LeadFreeCandy/Flux-Chess/esp32/docs/force_table_vectors.png

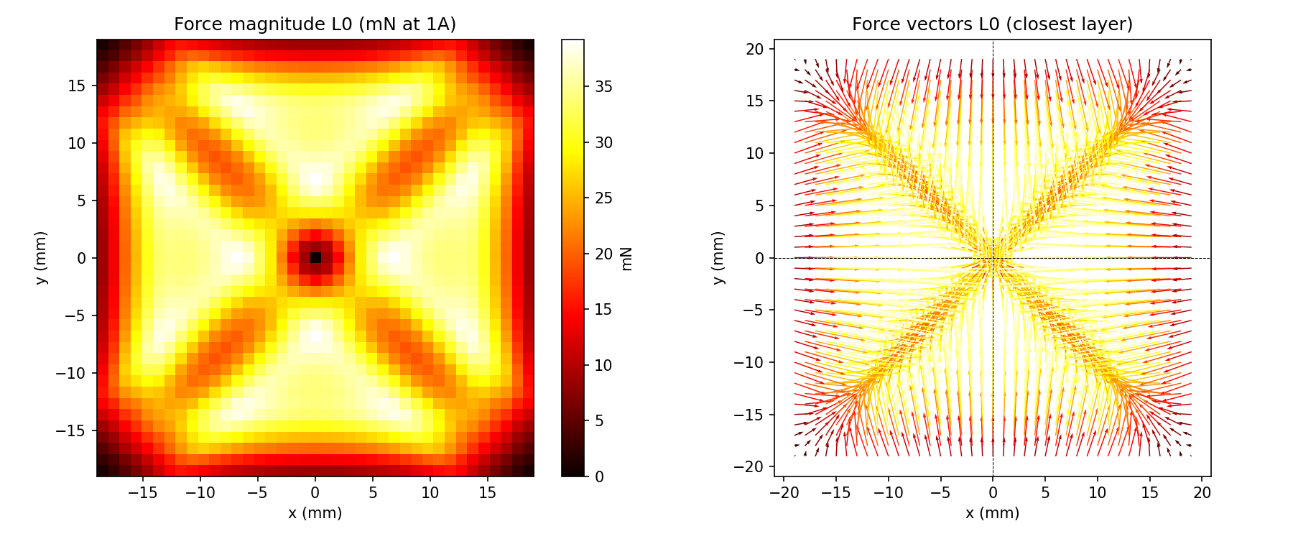
esp32/docs/force_table_vectors.png
