LeadFreeCandy/Flux-Chess/esp32/docs/force_table_layers.png

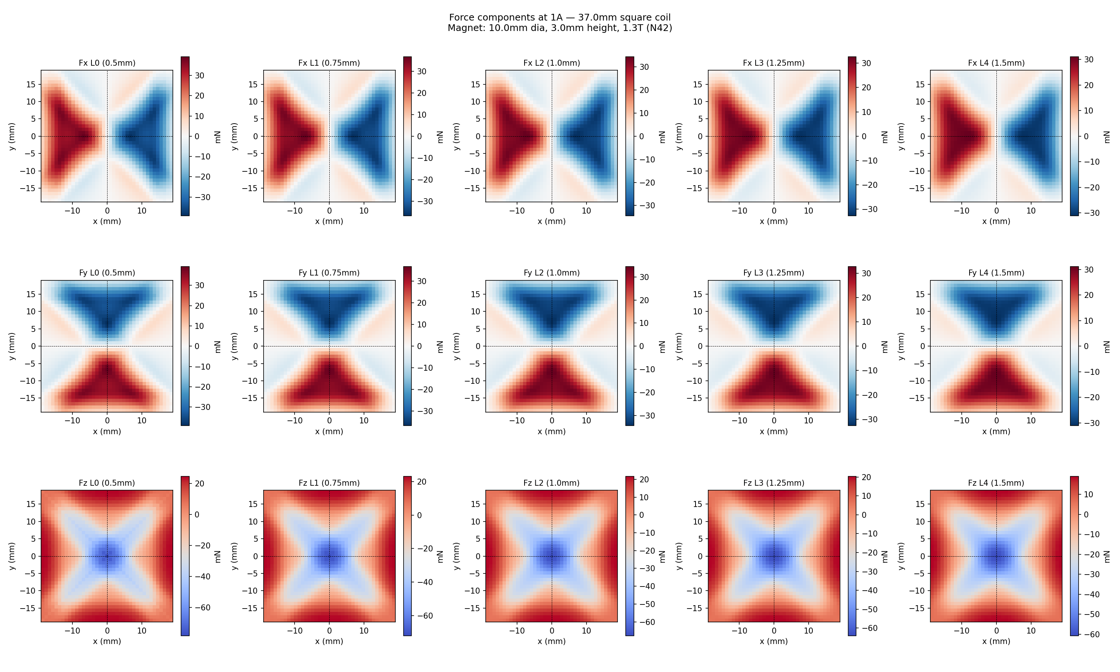
esp32/docs/force_table_layers.png
