LeadFreeCandy/Flux-Chess/coil_generation/coils_overlay.png

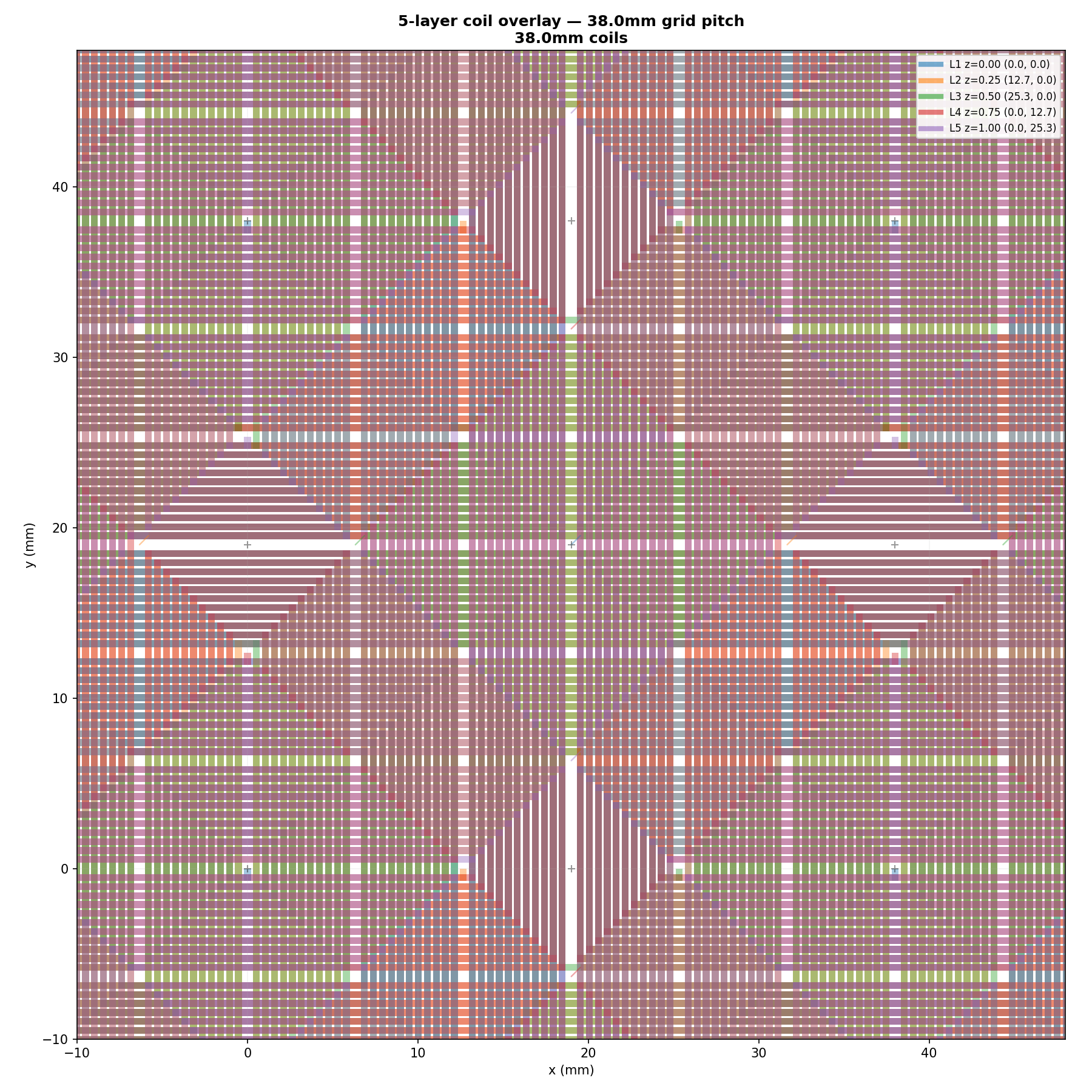
coil_generation/coils_overlay.png
