LeadFreeCandy/Flux-Chess/(list of files, cad)

Other CAD files:
pawn.dxf
