LeadFreeCandy/Flux-Chess/esp32/firmware/serial_server.h

#pragma once
#include <functional>
#include "board.h"

// ── Command Registry ──────────────────────────────────────────

using CommandHandler = std::function<String(Board& board, const String& params)>;

struct Command {
  const char* name;
  CommandHandler handler;
};

// ── Built-in command handlers ─────────────────────────────────

inline String handlePulseCoil(Board& board, const String& params) {
  return board.pulseCoil(
    jsonGet(params, "x").toInt(),
    jsonGet(params, "y").toInt(),
    jsonGet(params, "duration_ms").toInt()
  ).toJson();
}

inline String handleGetBoardState(Board& board, const String&) {
  return board.getBoardState().toJson();
}

inline String handleSetRGB(Board& board, const String& params) {
  return board.setRGB(
    jsonGet(params, "r").toInt(),
    jsonGet(params, "g").toInt(),
    jsonGet(params, "b").toInt()
  ).toJson();
}

inline String handleSetPiece(Board& board, const String& params) {
  uint8_t x = jsonGet(params, "x").toInt();
  uint8_t y = jsonGet(params, "y").toInt();
  uint8_t id = jsonGet(params, "id").toInt();
  board.setPiece(x, y, id);
  return Json().add("success", true).build();
}

inline String handleMoveDumb(Board& board, const String& params) {
  uint8_t fromX = jsonGet(params, "from_x").toInt();
  uint8_t fromY = jsonGet(params, "from_y").toInt();
  uint8_t toX = jsonGet(params, "to_x").toInt();
  uint8_t toY = jsonGet(params, "to_y").toInt();
  MoveError err = board.moveDumbOrthogonal(fromX, fromY, toX, toY);
  return Json()
    .add("success", err == MoveError::NONE)
    .add("error", err)
    .build();
}

inline String handleMovePhysics(Board& board, const String& params) {
  uint8_t fromX = jsonGet(params, "from_x").toInt();
  uint8_t fromY = jsonGet(params, "from_y").toInt();
  uint8_t toX = jsonGet(params, "to_x").toInt();
  uint8_t toY = jsonGet(params, "to_y").toInt();
  int maxRetries = jsonGet(params, "max_retries").toInt();  // defaults to 0 if absent
  MoveDiag diag;
  MoveError err = board.movePhysicsOrthogonal(fromX, fromY, toX, toY, false, maxRetries, &diag);
  MoveResponse res;
  res.success = (err == MoveError::NONE);
  res.error = err;
  res.has_diag = true;
  res.diag = diag;
  return res.toJson();
}

inline String handleMovePiece(Board& board, const String& params) {
  uint8_t fromX = jsonGet(params, "from_x").toInt();
  uint8_t fromY = jsonGet(params, "from_y").toInt();
  uint8_t toX = jsonGet(params, "to_x").toInt();
  uint8_t toY = jsonGet(params, "to_y").toInt();
  int maxRetries = jsonGet(params, "max_retries").toInt();
  MoveError err = board.movePiece(fromX, fromY, toX, toY, maxRetries);
  MoveResponse res;
  res.success = (err == MoveError::NONE);
  res.error = err;
  return res.toJson();
}

inline String handleSetPhysicsParams(Board& board, const String& params) {
  PhysicsParams p = board.getPhysicsParams();
  String v;
  if ((v = jsonGet(params, "piece_mass_g")).length())         p.piece_mass_g = v.toFloat();
  if ((v = jsonGet(params, "max_current_a")).length())        p.max_current_a = v.toFloat();
  if ((v = jsonGet(params, "mu_static")).length())            p.mu_static = v.toFloat();
  if ((v = jsonGet(params, "mu_kinetic")).length())           p.mu_kinetic = v.toFloat();
  if ((v = jsonGet(params, "target_velocity_mm_s")).length()) p.target_velocity_mm_s = v.toFloat();
  if ((v = jsonGet(params, "target_accel_mm_s2")).length())   p.target_accel_mm_s2 = v.toFloat();
  if ((v = jsonGet(params, "max_jerk_mm_s3")).length())       p.max_jerk_mm_s3 = v.toFloat();
  if ((v = jsonGet(params, "coast_friction_offset")).length()) p.coast_friction_offset = v.toFloat();
  if ((v = jsonGet(params, "brake_pulse_ms")).length())       p.brake_pulse_ms = v.toInt();
  if ((v = jsonGet(params, "pwm_freq_hz")).length())          p.pwm_freq_hz = v.toInt();
  if ((v = jsonGet(params, "pwm_compensation")).length())     p.pwm_compensation = v.toFloat();
  if ((v = jsonGet(params, "all_coils_equal")).length())      p.all_coils_equal = (v == "true" || v == "1");
  if ((v = jsonGet(params, "force_scale")).length())          p.force_scale = v.toFloat();
  if ((v = jsonGet(params, "max_duration_ms")).length())      p.max_duration_ms = v.toInt();
  if ((v = jsonGet(params, "max_retry_attempts")).length())  p.max_retry_attempts = v.toInt();
  if ((v = jsonGet(params, "tick_ms")).length())             p.tick_ms = v.toInt();
  if ((v = jsonGet(params, "droop_per_piece")).length())     p.droop_per_piece = v.toFloat();
  board.setPhysicsParams(p);
  return board.physicsParamsToJson();
}

inline String handleGetPhysicsParams(Board& board, const String&) {
  return board.physicsParamsToJson();
}

inline String handleDiagonalTest(Board& board, const String& params) {
  uint8_t fromX = jsonGet(params, "from_x").toInt();
  uint8_t fromY = jsonGet(params, "from_y").toInt();
  uint8_t toX = jsonGet(params, "to_x").toInt();
  uint8_t toY = jsonGet(params, "to_y").toInt();
  Board::DiagonalParams dp;
  String v;
  if ((v = jsonGet(params, "catapult_ms")).length())   dp.catapult_ms = v.toInt();
  if ((v = jsonGet(params, "catapult_duty")).length())  dp.catapult_duty = v.toInt();
  if ((v = jsonGet(params, "delay1_ms")).length())      dp.delay1_ms = v.toInt();
  if ((v = jsonGet(params, "catch_ms")).length())       dp.catch_ms = v.toInt();
  if ((v = jsonGet(params, "catch_duty")).length())     dp.catch_duty = v.toInt();
  if ((v = jsonGet(params, "delay2_ms")).length())      dp.delay2_ms = v.toInt();
  if ((v = jsonGet(params, "center_ms")).length())      dp.center_ms = v.toInt();
  return board.diagonalTest(fromX, fromY, toX, toY, dp);
}

inline String handleMoveMulti(Board& board, const String& params) {
  // Parse array of moves: "moves": [{"from_x":0,"from_y":0,"to_x":3,"to_y":0}, ...]
  // Simple parsing: look for from_x/from_y/to_x/to_y with index suffixes
  Board::MultiMoveRequest moves[Board::MAX_MULTI_MOVES];
  int count = 0;

  for (int i = 0; i < Board::MAX_MULTI_MOVES; i++) {
    String prefix = String(i) + "_";
    String fx = jsonGet(params, (prefix + "from_x").c_str());
    if (!fx.length()) break;
    moves[count].from_x = fx.toInt();
    moves[count].from_y = jsonGet(params, (prefix + "from_y").c_str()).toInt();
    moves[count].to_x = jsonGet(params, (prefix + "to_x").c_str()).toInt();
    moves[count].to_y = jsonGet(params, (prefix + "to_y").c_str()).toInt();
    count++;
  }

  if (count == 0) {
    return Json().add("success", false).addStr("error", "no moves").build();
  }

  return board.moveMulti(moves, count);
}

inline String handleEdgeMoveTest(Board& board, const String& params) {
  bool up = jsonGet(params, "direction") != "down";
  Board::EdgeMoveParams ep;
  String v;
  if ((v = jsonGet(params, "pulse_ms")).length()) ep.pulse_ms = v.toInt();
  if ((v = jsonGet(params, "duty")).length())     ep.duty = v.toInt();
  if ((v = jsonGet(params, "delay_ms")).length()) ep.delay_ms = v.toInt();
  if ((v = jsonGet(params, "steps")).length())    ep.steps = v.toInt();
  return board.edgeMoveTest(up, ep);
}

inline String handleCenterPiece(Board& board, const String& params) {
  Board::CenterPieceParams cp;
  String v;
  if ((v = jsonGet(params, "x")).length())          cp.x = v.toInt();
  if ((v = jsonGet(params, "y")).length())          cp.y = v.toInt();
  if ((v = jsonGet(params, "center1_ms")).length()) cp.center1_ms = v.toInt();
  if ((v = jsonGet(params, "adj_ms")).length())     cp.adj_ms = v.toInt();
  if ((v = jsonGet(params, "between_ms")).length()) cp.between_ms = v.toInt();
  if ((v = jsonGet(params, "axis_switch_ms")).length()) cp.axis_switch_ms = v.toInt();
  if ((v = jsonGet(params, "center2_ms")).length()) cp.center2_ms = v.toInt();
  if ((v = jsonGet(params, "adj_repeats")).length()) cp.adj_repeats = v.toInt();
  return board.centerPiece(cp);
}

inline String handleResetBoard(Board& board, const String&) {
  return board.resetBoard();
}

inline String handleHexapawnPlay(Board& board, const String& params) {
  uint16_t hint_ms = 0;
  uint16_t hint_interval_ms = 1000;
  String v = jsonGet(params, "hint_pulse_ms");
  if (v.length()) hint_ms = v.toInt();
  v = jsonGet(params, "hint_interval_ms");
  if (v.length()) hint_interval_ms = v.toInt();
  return board.hexapawnPlay(hint_ms, hint_interval_ms);
}

inline String handleTunePhysics(Board& board, const String& params) {
  return board.tunePhysics();
}

inline String handleGetCalibration(Board& board, const String&) {
  return board.getCalibration().toJson();
}

inline String handleCalibrate(Board& board, const String&) {
  return board.calibrate().toJson();
}

inline String handleShutdown(Board& board, const String&) {
  return ShutdownResponse{}.toJson();
}

// ── Serial Server ─────────────────────────────────────────────

class SerialServer {
public:
  SerialServer(Board& board) : board_(board), num_commands_(0) {
    on("pulse_coil", handlePulseCoil);
    on("get_board_state", handleGetBoardState);
    on("set_piece", handleSetPiece);
    on("move_dumb", handleMoveDumb);
    on("move_physics", handleMovePhysics);
    on("move_piece", handleMovePiece);
    on("set_physics_params", handleSetPhysicsParams);
    on("get_physics_params", handleGetPhysicsParams);
    on("tune_physics", handleTunePhysics);
    on("hexapawn_play", handleHexapawnPlay);
    on("reset_board", handleResetBoard);
    on("diagonal_test", handleDiagonalTest);
    on("edge_move_test", handleEdgeMoveTest);
    on("center_piece", handleCenterPiece);
    on("move_multi", handleMoveMulti);
    on("set_rgb", handleSetRGB);
    on("calibrate", handleCalibrate);
    on("get_calibration", handleGetCalibration);
    on("shutdown", handleShutdown);
  }

  void on(const char* name, CommandHandler handler) {
    if (num_commands_ < MAX_COMMANDS) {
      commands_[num_commands_++] = { name, handler };
    }
  }

  void poll() {
    while (Serial.available()) {
      char c = Serial.read();
      if (c == '\n') {
        line_buf_.trim();
        if (line_buf_.length() > 0) {
          handleCommand(line_buf_);
        }
        line_buf_ = "";
      } else {
        line_buf_ += c;
      }
    }
  }

private:
  static const int MAX_COMMANDS = 32;
  Board& board_;
  String line_buf_;
  Command commands_[MAX_COMMANDS];
  int num_commands_;

  void handleCommand(const String& line) {
    String method = jsonGet(line, "method");
    if (method.length() == 0) return;

    String params = jsonGetObj(line, "params");

    for (int i = 0; i < num_commands_; i++) {
      if (method == commands_[i].name) {
        String result = commands_[i].handler(board_, params);
        Serial.printf("{\"method\":\"%s\",\"result\":%s}\n",
                      commands_[i].name, result.c_str());
        if (method == "shutdown") {
          delay(50);
          board_.shutdown();
        }
        return;
      }
    }

    Serial.printf("{\"method\":\"%s\",\"error\":\"unknown command\"}\n", method.c_str());
  }
};
