LeadFreeCandy/Flux-Chess/esp32/firmware-rs/src/board.rs

extern crate alloc;
use alloc::vec::Vec;

use crate::api::*;
use crate::hardware::Hardware;
use crate::pins::NUM_HALL_SENSORS;

// ── Coil Grid Mapping ─────────────────────────────────────
//
// 12 shift registers in a 4-column × 3-row grid.
// Each SR drives 5 coils in an L-shape within a 3×3 block:
//
//   (0,2)  .     .       bit 4
//   (0,1)  .     .       bit 3
//   (0,0) (1,0) (2,0)    bit 2, bit 1, bit 0
//
// SR layout (4 cols × 3 rows, each offset by 3):
//   SR0  @ (0,0)   SR1  @ (3,0)   SR2  @ (6,0)   SR3  @ (9,0)
//   SR4  @ (0,3)   SR5  @ (3,3)   SR6  @ (6,3)   SR7  @ (9,3)
//   SR8  @ (0,6)   SR9  @ (3,6)   SR10 @ (6,6)   SR11 @ (9,6)

const SR_COLS: usize = 4;
const SR_ROWS: usize = 3;
const SR_BLOCK: usize = 3;

pub struct Board {
    hw: Hardware,
    event_queue: Vec<BoardEvent>,
}

impl Board {
    pub fn new(hw: Hardware) -> Self {
        Self {
            hw,
            event_queue: Vec::new(),
        }
    }

    // ── Monitor Tick ──────────────────────────────────────────

    pub fn tick(&mut self) {
        // TODO: read sensors, detect changes, push events
    }

    pub fn drain_events(&mut self) -> Vec<BoardEvent> {
        core::mem::take(&mut self.event_queue)
    }

    // ── Coil Control ──────────────────────────────────────────

    pub fn pulse_coil(&mut self, x: u8, y: u8, duration_us: u32) -> PulseResult {
        log::info!("pulseCoil: request at grid ({},{}) for {}us", x, y, duration_us);

        if x as usize >= GRID_COLS || y as usize >= GRID_ROWS {
            log::warn!("pulseCoil REJECT: ({},{}) out of bounds ({}x{})", x, y, GRID_COLS, GRID_ROWS);
            return PulseResult::Failure(PulseError::InvalidCoil);
        }

        let bit = match Self::coord_to_bit(x, y) {
            Some(b) => b,
            None => {
                let lx = x as usize % SR_BLOCK;
                let ly = y as usize % SR_BLOCK;
                log::warn!("pulseCoil REJECT: ({},{}) no coil (local {},{} in block {},{})",
                    x, y, lx, ly, x as usize / SR_BLOCK, y as usize / SR_BLOCK);
                return PulseResult::Failure(PulseError::InvalidCoil);
            }
        };

        let sr = bit / 8;
        let pin = bit % 8;
        log::info!("pulseCoil: ({},{}) -> SR{} pin {} (bit {}), delegating to hw", x, y, sr, pin, bit);

        let result = self.hw.pulse_bit(bit, duration_us);
        match &result {
            PulseResult::Success => log::info!("pulseCoil OK: ({},{}) pulsed for {}us via SR{} pin {}", x, y, duration_us, sr, pin),
            PulseResult::Failure(e) => log::warn!("pulseCoil FAIL: SR{} pin {} ({:?})", sr, pin, e),
        }
        result
    }

    // ── Board State ───────────────────────────────────────────

    pub fn get_board_state(&mut self) -> BoardStateResponse {
        BoardStateResponse {
            raw_sensor_values: self.hw.read_all_sensors(),
            ids: [[0u8; GRID_ROWS]; GRID_COLS],
            timestamps: [[0u64; GRID_ROWS]; GRID_COLS],
        }
    }

    // ── Calibration ──────────────────────────────────────────

    pub fn calibrate(&mut self, _samples: u8, _pulse_us: u32) -> CalibrationResult {
        // TODO: implement calibration
        CalibrationResult {
            sensors: core::array::from_fn(|_| core::array::from_fn(|_| SensorCalibration {
                baseline: 0, coil_on: 0, magnet_present: 0,
            })),
        }
    }

    // ── Move Piece ───────────────────────────────────────────

    // TODO: implement move_piece
    // pub fn move_piece(&mut self, from: (u8, u8), to: (u8, u8)) -> MoveResult { ... }

    // ── RGB ───────────────────────────────────────────────────

    pub fn set_rgb(&mut self, r: u8, g: u8, b: u8) -> CommandResult {
        log::info!("setRGB: r={} g={} b={} (#{:02X}{:02X}{:02X})", r, g, b, r, g, b);
        self.hw.set_rgb(r, g, b);
        CommandResult { success: true }
    }

    // ── System ────────────────────────────────────────────────

    pub fn shutdown(&mut self) -> ! {
        log::info!("shutdown: delegating to hardware for safe powerdown");
        self.hw.shutdown()
    }

    pub fn watchdog_tick(&mut self) {
        self.hw.watchdog_tick(MAX_PULSE_US);
    }

    // ── Grid Mapping ──────────────────────────────────────────

    fn coord_to_bit(x: u8, y: u8) -> Option<usize> {
        let sr_col = x as usize / SR_BLOCK;
        let sr_row = y as usize / SR_BLOCK;
        if sr_col >= SR_COLS || sr_row >= SR_ROWS { return None; }

        // Column-major: go up first, then right
        let sr_index = sr_col * SR_ROWS + sr_row;
        let lx = x as usize % SR_BLOCK;
        let ly = y as usize % SR_BLOCK;

        let local_bit = if ly == 0 {
            Some(2 - lx)
        } else if lx == 0 {
            Some(2 + ly)
        } else {
            None
        };

        local_bit.map(|b| sr_index * 8 + b)
    }
}
