LeadFreeCandy/Flux-Chess/esp32/tests/verify_physics.cpp

// Comprehensive physics simulation verification & fuzz tester
// Mirrors firmware physics.h logic exactly, with analytical cross-checks.
// Compile: cd esp32/tests && g++ -std=c++17 -O2 -o verify_physics verify_physics.cpp && ./verify_physics
// Use -v for verbose logging, -vv for per-tick traces

#include <cstdio>
#include <cstdint>
#include <cstring>
#include <cmath>
#include <cassert>
#include <vector>
#include <string>
#include <random>
#include <algorithm>
#include <functional>

// ═══════════════════════════════════════════════════════════════
// Stubs matching firmware environment
// ═══════════════════════════════════════════════════════════════

static int g_verbosity = 0;  // 0=quiet, 1=verbose, 2=per-tick

#define LOG_BOARD(fmt, ...) do { if (g_verbosity >= 1) printf("[BOARD] " fmt "\n", ##__VA_ARGS__); } while(0)
#define LOG_HW(fmt, ...)   do { if (g_verbosity >= 2) printf("[HW]    " fmt "\n", ##__VA_ARGS__); } while(0)

enum class MoveError : uint8_t {
  NONE, OUT_OF_BOUNDS, SAME_POSITION, NOT_ORTHOGONAL,
  NO_PIECE_AT_SOURCE, PATH_BLOCKED, COIL_FAILURE
};

// ═══════════════════════════════════════════════════════════════
// Structs matching firmware physics.h exactly
// ═══════════════════════════════════════════════════════════════

static constexpr float GRID_TO_MM = 38.0f / 3.0f;

struct PieceState {
  float x, y;     // mm
  float vx, vy;   // mm/s
  bool stuck;
  void reset(float px_mm, float py_mm) {
    x = px_mm; y = py_mm; vx = 0; vy = 0; stuck = true;
  }
};

struct PhysicsParams {
  float piece_mass_g         = 2.7f;
  float max_current_a        = 1.0f;
  float mu_static            = 0.35f;
  float mu_kinetic           = 0.25f;
  float target_velocity_mm_s = 100.0f;
  float target_accel_mm_s2   = 500.0f;
  float max_jerk_mm_s3       = 50000.0f;
  float coast_friction_offset = 0.0f;
  uint16_t brake_pulse_ms    = 100;
  uint16_t pwm_freq_hz       = 20000;
  float pwm_compensation     = 0.2f;
  bool  all_coils_equal      = false;
  float force_scale          = 1.0f;
  uint16_t max_duration_ms   = 5000;
};

// Tuned params from working hardware
static PhysicsParams tunedParams() {
  PhysicsParams p;
  p.piece_mass_g = 2.7f;
  p.max_current_a = 1.2f;
  p.mu_static = 0.55f;
  p.mu_kinetic = 0.45f;
  p.target_velocity_mm_s = 300.0f;
  p.target_accel_mm_s2 = 1500.0f;
  p.max_jerk_mm_s3 = 20000.0f;
  p.pwm_compensation = 0.2f;
  p.force_scale = 1.0f;
  p.max_duration_ms = 5000;
  p.brake_pulse_ms = 100;
  return p;
}

// ═══════════════════════════════════════════════════════════════
// Stub force model (approximates real force tables)
// ═══════════════════════════════════════════════════════════════

// Force model fitted to actual force_tables.h data (37mm square coil, 12mm N42 magnet)
// Real table center-row Fx profile (layer 0):
//   1mm: ~10.7mN, 5mm: ~40mN, 8mm: ~51mN (peak), 13mm: ~31mN, 19mm: ~14mN
// The large coil produces a broad force plateau, not a sharp peak.

static constexpr float LAYER_ATTEN[] = {1.0f, 0.75f, 0.55f, 0.40f, 0.28f};

// Better fit: F(d) = A * d * exp(-d/B) / C — captures broad plateau of real coil
// Tuned to match: peak ~54mN at d~7mm, ~31mN at d=13mm, ~14mN at d=19mm
static float forceProfile(float d_mm) {
  if (d_mm < 0.01f) return 0;
  // Piecewise: ramp up to peak then exponential decay
  float f = 54.0f * d_mm * expf(-d_mm / 11.0f) / (7.0f * expf(-7.0f / 11.0f));
  return f;
}

float stubForceFx(int layer, float dx_mm, float dy_mm) {
  float d = sqrtf(dx_mm * dx_mm + dy_mm * dy_mm);
  if (d < 0.01f) return 0;
  float f = forceProfile(d);
  float atten = (layer >= 0 && layer < 5) ? LAYER_ATTEN[layer] : 0.3f;
  return -f * (dx_mm / d) * atten;
}

float stubForceFy(int layer, float dx_mm, float dy_mm) {
  float d = sqrtf(dx_mm * dx_mm + dy_mm * dy_mm);
  if (d < 0.01f) return 0;
  float f = forceProfile(d);
  float atten = (layer >= 0 && layer < 5) ? LAYER_ATTEN[layer] : 0.3f;
  return -f * (dy_mm / d) * atten;
}

float stubForceFz(int layer, float dx_mm, float dy_mm) {
  float d = sqrtf(dx_mm * dx_mm + dy_mm * dy_mm);
  float atten = (layer >= 0 && layer < 5) ? LAYER_ATTEN[layer] : 0.3f;
  return -101.0f / (1.0f + d * d * 0.01f) * atten;
}

float stubForceHMag(int layer, float d_mm) {
  if (d_mm < 0.01f) return 0;
  float atten = (layer >= 0 && layer < 5) ? LAYER_ATTEN[layer] : 0.3f;
  return forceProfile(d_mm) * atten;
}

// ═══════════════════════════════════════════════════════════════
// Simulation that mirrors firmware physics.h execute() exactly
// ═══════════════════════════════════════════════════════════════

struct SimResult {
  MoveError error;
  float final_x, final_y;
  float final_vx, final_vy;
  float elapsed_ms;
  int ticks;
  float max_speed;
  float max_accel;
  int coil_switches;
  bool coasted;
  bool centered;
  std::vector<float> speed_history;    // per-tick speed
  std::vector<float> accel_history;    // per-tick acceleration
  std::vector<float> duty_history;     // per-tick duty
  std::vector<float> position_history; // position along move axis
};

// coordToBit stub — returns layer based on position (simplified)
static int layerForCoil(int coil_idx) {
  // In real firmware, each coil in an SR block is on a different layer.
  // For testing, cycle through layers.
  static constexpr int BIT_TO_LAYER[] = {3, 4, 0, 2, 1};
  return BIT_TO_LAYER[coil_idx % 5];
}

SimResult simulateFirmwarePhysics(PieceState& piece,
                                   const float path_mm[][2], int path_len,
                                   const PhysicsParams& params,
                                   bool record_history = false)
{
  SimResult result{};
  result.error = MoveError::COIL_FAILURE;

  if (path_len < 1) return result;
  if (params.piece_mass_g <= 0 || params.max_current_a <= 0 || params.target_velocity_mm_s <= 0) {
    return result;
  }

  int coil_idx = 0;
  float cx = path_mm[0][0], cy = path_mm[0][1];

  float dx = path_mm[path_len - 1][0] - piece.x;
  float dy = path_mm[path_len - 1][1] - piece.y;
  bool moveX = (fabsf(dx) > fabsf(dy));
  float move_sign = moveX ? (dx > 0 ? 1.0f : -1.0f) : (dy > 0 ? 1.0f : -1.0f);

  int activeLayer = params.all_coils_equal ? 0 : layerForCoil(coil_idx);

  float weight_mN = params.piece_mass_g * 9.81f;
  float mass_kg = params.piece_mass_g * 1e-3f;

  uint8_t last_duty = 255;
  float last_current = params.max_current_a;
  float last_accel = 0;
  float max_speed = 0;
  float max_accel_seen = 0;
  bool coasting = false;
  bool centered_flag = false;
  bool braked = false;
  int coil_switches = 0;

  static constexpr float COAST_TOLERANCE_MM = 3.0f;
  static constexpr float ARRIVAL_DIST_MM = 1.0f;
  static constexpr float ARRIVAL_SPEED_MM_S = 5.0f;
  static constexpr float CENTERED_SPEED_MM_S = 10.0f;
  static constexpr float SPEED_CLAMP_FACTOR = 1.5f;

  float dt = 0.01f; // 10ms fixed tick (matches firmware minimum)
  float elapsed_s = 0;
  float max_s = params.max_duration_ms / 1000.0f;

  while (elapsed_s < max_s) {
    if (dt > 0.05f) dt = 0.05f;
    elapsed_s += dt;
    result.ticks++;

    // 2. Offset from active coil
    float off_x = piece.x - cx;
    float off_y = piece.y - cy;

    // 3. Force table lookup (mN at 1A)
    float fx_1a = stubForceFx(activeLayer, off_x, off_y) * params.force_scale;
    float fy_1a = stubForceFy(activeLayer, off_x, off_y) * params.force_scale;
    float fz_1a = stubForceFz(activeLayer, off_x, off_y) * params.force_scale;

    float speed = sqrtf(piece.vx * piece.vx + piece.vy * piece.vy);
    float v_along = (moveX ? piece.vx : piece.vy) * move_sign;

    // 4. Dynamic friction
    float normal_mN = weight_mN - fz_1a * last_current;
    if (normal_mN < 0) normal_mN = 0;
    float mu = (piece.stuck || speed < 0.1f) ? params.mu_static : params.mu_kinetic;
    float friction_mN = mu * normal_mN;

    // 5. Static friction check
    if (piece.stuck) {
      float avail = sqrtf(fx_1a * fx_1a + fy_1a * fy_1a) * params.max_current_a;
      float static_fric = params.mu_static * fmaxf(weight_mN - fz_1a * params.max_current_a, 0.0f);
      if (avail > fmaxf(static_fric, 0)) {
        piece.stuck = false;
      } else {
        continue;
      }
    }

    float fx, fy;
    uint8_t duty;

    if (!coasting) {
      // 6. Stopping check
      float dest_x = path_mm[path_len-1][0];
      float dest_y = path_mm[path_len-1][1];
      float dist_remain = moveX ? (dest_x - piece.x) * move_sign : (dest_y - piece.y) * move_sign;

      float coast_mu = params.mu_kinetic + params.coast_friction_offset;
      float friction_decel = (weight_mN > 0) ? coast_mu * weight_mN / mass_kg : 0;
      float stopping_dist = (friction_decel > 0.01f) ? (v_along * v_along) / (2.0f * friction_decel) : 9999.0f;

      if (v_along > 0 && dist_remain > 0 && stopping_dist >= dist_remain) {
        coasting = true;
        last_current = 0;  // matches firmware fix — no coil active during coast
        normal_mN = weight_mN;  // recompute: no Fz with coils off (fixes first-tick stale value)
      }
    }

    if (coasting) {
      fx = 0; fy = 0; duty = 0;

      float dest_x = path_mm[path_len-1][0];
      float dest_y = path_mm[path_len-1][1];
      float d_dest = sqrtf((piece.x-dest_x)*(piece.x-dest_x) + (piece.y-dest_y)*(piece.y-dest_y));

      if (!centered_flag && params.brake_pulse_ms > 0 && d_dest < COAST_TOLERANCE_MM && speed < 20.0f) {
        // Centering pulse — in firmware this is a blocking pulseBit, we simulate as a snap
        centered_flag = true;
        braked = true;
      }
    } else {
      // 7. Controller
      float speed_error = params.target_velocity_mm_s - v_along;
      float desired_accel = fminf(fmaxf(speed_error / dt, 0.0f), params.target_accel_mm_s2);

      // Jerk limit
      float max_da = params.max_jerk_mm_s3 * dt;
      float da = desired_accel - last_accel;
      if (da > max_da) desired_accel = last_accel + max_da;
      else if (da < -max_da) desired_accel = last_accel - max_da;
      last_accel = desired_accel;

      float desired_force = mass_kg * desired_accel + friction_mN;
      if (desired_force < 0) desired_force = 0;

      float avail_lateral = sqrtf(fx_1a * fx_1a + fy_1a * fy_1a);
      float required_current = (avail_lateral > 0.01f) ? desired_force / avail_lateral : params.max_current_a;
      required_current = fminf(required_current, params.max_current_a);
      if (required_current < 0) required_current = 0;

      // PWM compensation
      float desired_eff_duty = required_current / params.max_current_a * 255.0f;
      float comp = params.pwm_compensation;
      float raw_duty = (comp < 0.99f) ? (desired_eff_duty - 255.0f * comp) / (1.0f - comp) : 0;
      if (raw_duty < 0) raw_duty = 0;
      if (raw_duty > 255) raw_duty = 255;
      duty = (uint8_t)raw_duty;
      float eff_duty = duty + (255.0f - duty) * comp;
      float actual_current = (eff_duty / 255.0f) * params.max_current_a;
      last_current = actual_current;

      fx = fx_1a * actual_current;
      fy = fy_1a * actual_current;
    }

    // 8. Apply friction
    if (speed > 0.1f) {
      float fric = params.mu_kinetic * fmaxf(normal_mN, 0);
      float max_fric = speed / dt * mass_kg;
      if (fric > max_fric) fric = max_fric;
      fx -= fric * (piece.vx / speed);
      fy -= fric * (piece.vy / speed);
    }

    // 9. Update velocity
    float ax_tick = fx / mass_kg;
    float ay_tick = fy / mass_kg;
    piece.vx += ax_tick * dt;
    piece.vy += ay_tick * dt;

    float accel_mag = sqrtf(ax_tick * ax_tick + ay_tick * ay_tick);
    if (accel_mag > max_accel_seen) max_accel_seen = accel_mag;

    speed = sqrtf(piece.vx * piece.vx + piece.vy * piece.vy);
    if (speed > params.target_velocity_mm_s * SPEED_CLAMP_FACTOR) {
      float scale = params.target_velocity_mm_s * SPEED_CLAMP_FACTOR / speed;
      piece.vx *= scale; piece.vy *= scale;
      speed = params.target_velocity_mm_s * SPEED_CLAMP_FACTOR;
    }
    if (speed > max_speed) max_speed = speed;

    // 10. Update position
    piece.x += piece.vx * dt;
    piece.y += piece.vy * dt;

    // Record history
    if (record_history) {
      result.speed_history.push_back(speed);
      result.accel_history.push_back(accel_mag);
      result.duty_history.push_back((float)duty);
      float pos_along = moveX ? piece.x : piece.y;
      result.position_history.push_back(pos_along);
    }

    // Per-tick trace
    if (g_verbosity >= 2 && result.ticks % 5 == 0) {
      printf("  t=%6.1fms pos=(%.1f,%.1f) v=(%.1f,%.1f) duty=%d %s\n",
             elapsed_s*1000, piece.x, piece.y, piece.vx, piece.vy, duty,
             coasting ? (braked ? "BRAKE" : "COAST") : "");
    }

    // 11. Coil switching — switch when next coil produces greater forward acceleration
    if (!coasting && coil_idx < path_len - 1) {
      float next_cx = path_mm[coil_idx + 1][0];
      float next_cy = path_mm[coil_idx + 1][1];
      float next_off_x = piece.x - next_cx;
      float next_off_y = piece.y - next_cy;
      int nextLayer = params.all_coils_equal ? 0 : layerForCoil(coil_idx + 1);

      float cur_fx_move = moveX ? fx_1a : fy_1a;
      float cur_forward = cur_fx_move * move_sign * params.max_current_a;
      float cur_normal = fmaxf(weight_mN - fz_1a * params.max_current_a, 0.0f);
      float cur_net = cur_forward - params.mu_kinetic * cur_normal;

      float nfx = stubForceFx(nextLayer, next_off_x, next_off_y) * params.force_scale;
      float nfy = stubForceFy(nextLayer, next_off_x, next_off_y) * params.force_scale;
      float nfz = stubForceFz(nextLayer, next_off_x, next_off_y) * params.force_scale;
      float next_fx_move = moveX ? nfx : nfy;
      float next_forward = next_fx_move * move_sign * params.max_current_a;
      float next_normal = fmaxf(weight_mN - nfz * params.max_current_a, 0.0f);
      float next_net = next_forward - params.mu_kinetic * next_normal;

      if (next_net > cur_net) {
        coil_idx++;
        cx = path_mm[coil_idx][0];
        cy = path_mm[coil_idx][1];
        activeLayer = params.all_coils_equal ? 0 : layerForCoil(coil_idx);
        last_duty = 255;
        last_current = params.max_current_a;
        coil_switches++;
      }
    }

    // 12. PWM update (tracked but no hardware)
    if (!coasting && abs((int)duty - (int)last_duty) > 2) {
      last_duty = duty;
    }

    // 13. Arrival check
    {
      float dest_x = path_mm[path_len-1][0];
      float dest_y = path_mm[path_len-1][1];
      float d_dest = sqrtf((piece.x-dest_x)*(piece.x-dest_x) + (piece.y-dest_y)*(piece.y-dest_y));
      bool arrived = (centered_flag && speed < CENTERED_SPEED_MM_S) || (d_dest < ARRIVAL_DIST_MM && speed < ARRIVAL_SPEED_MM_S);

      if (arrived) {
        piece.x = dest_x; piece.y = dest_y;
        piece.vx = 0; piece.vy = 0;
        piece.stuck = true;
        result.error = MoveError::NONE;
        break;
      }
    }
  }

  result.final_x = piece.x;
  result.final_y = piece.y;
  result.final_vx = piece.vx;
  result.final_vy = piece.vy;
  result.elapsed_ms = elapsed_s * 1000;
  result.max_speed = max_speed;
  result.max_accel = max_accel_seen;
  result.coil_switches = coil_switches;
  result.coasted = coasting;
  result.centered = centered_flag;
  return result;
}

// ═══════════════════════════════════════════════════════════════
// Test harness
// ═══════════════════════════════════════════════════════════════

static int tests_passed = 0;
static int tests_failed = 0;
static int issues_found = 0;

struct Issue {
  std::string category;
  std::string description;
  std::string severity; // "BUG", "WARNING", "NOTE"
};
static std::vector<Issue> issues;

static void reportIssue(const char* severity, const char* category, const char* fmt, ...) {
  char buf[512];
  va_list args;
  va_start(args, fmt);
  vsnprintf(buf, sizeof(buf), fmt, args);
  va_end(args);
  issues.push_back({category, buf, severity});
  issues_found++;
  printf("  *** %s [%s]: %s\n", severity, category, buf);
}

#define TEST(name) \
  printf("  %-55s ", name); \
  {

#define EXPECT(cond) \
  if (!(cond)) { \
    printf("FAIL (%s:%d: %s)\n", __FILE__, __LINE__, #cond); \
    tests_failed++; \
  } else

#define PASS \
  { printf("OK\n"); tests_passed++; }

#define END_TEST }

// Helper: build path in mm
static void buildPath(float out[][2], float start_mm, float end_mm, bool x_axis, float fixed_mm, int* len) {
  float step = GRID_TO_MM;
  float dir = (end_mm > start_mm) ? 1.0f : -1.0f;
  int n = 0;
  float pos = start_mm + step * dir;
  while ((dir > 0 && pos <= end_mm + 0.01f) || (dir < 0 && pos >= end_mm - 0.01f)) {
    if (x_axis) { out[n][0] = pos; out[n][1] = fixed_mm; }
    else        { out[n][0] = fixed_mm; out[n][1] = pos; }
    n++;
    if (fabsf(pos - end_mm) < 0.01f) break;
    pos += step * dir;
  }
  *len = n;
}

// ═══════════════════════════════════════════════════════════════
// TEST SUITES
// ═══════════════════════════════════════════════════════════════

// --- 1. Unit consistency ---
void test_unit_consistency() {
  printf("\n=== Unit Consistency Checks ===\n");

  PhysicsParams p = tunedParams();
  float mass_kg = p.piece_mass_g * 1e-3f;
  float weight_mN = p.piece_mass_g * 9.81f;

  TEST("Weight calculation: g -> mN") {
    float expected = p.piece_mass_g * 9.81f;
    EXPECT(fabsf(weight_mN - expected) < 0.01f) PASS;
  } END_TEST

  TEST("Mass conversion: g -> kg") {
    EXPECT(fabsf(mass_kg - p.piece_mass_g * 1e-3f) < 0.0001f) PASS;
  } END_TEST

  TEST("F=ma units: mN / kg = mm/s^2") {
    // 1 mN = 0.001 N; F/m = 0.001 / 0.0043 = 0.2326 m/s^2 = 232.6 mm/s^2
    float force_mN = 1.0f;
    float accel = force_mN / mass_kg; // should be in mm/s^2
    // Actually mN/kg = 1e-3 N / (mass_g * 1e-3 kg) = 1/mass_g [m/s^2]
    // But we want mm/s^2, so mN/kg gives m/s^2 not mm/s^2!
    // 1 mN / 0.0043 kg = 0.2326 m/s^2 = 232.6 mm/s^2
    // BUT the code does: piece.vx += (fx / mass_kg) * dt where fx is in mN
    // mN / kg = 1e-3 N / kg = 1e-3 m/s^2... wait.
    // mN = millinewton = 1e-3 N
    // mass_kg = 4.3e-3 kg
    // F/m = 1e-3 / 4.3e-3 = 0.2326 m/s^2 = 232.6 mm/s^2
    // But vx is in mm/s, so we need accel in mm/s^2
    // The code does vx (mm/s) += (F_mN / mass_kg) * dt
    // F_mN / mass_kg has units mN/kg = 1e-3 N/kg = 1e-3 m/s^2
    // This gives 0.2326 m/s^2, but vx is in mm/s, so we'd be adding 0.2326 m/s^2 * dt(s) = m/s units to mm/s!
    // UNIT MISMATCH!

    // Let's check: 10 mN / 0.0043 kg = 2.326 m/s^2
    // Over dt=0.01s: dv = 2.326 * 0.01 = 0.02326 m/s = 23.26 mm/s
    // But the code treats it as 2.326 mm/s change... which is 1000x too small.

    // Wait, let me re-check. force tables give values in mN at 1A.
    // Peak is 54 mN. mass_kg = 0.0043.
    // 54 / 0.0043 = 12558. If this is m/s^2, that's 12558 m/s^2 = insane.
    // If treated as mm/s^2 (which is what we want), 12558 mm/s^2 = 12.6 m/s^2 = reasonable.

    // So the question is: does mN / kg = mm/s^2?
    // mN / kg = (1e-3 N) / kg = 1e-3 m/s^2 = 1 mm/s^2. YES!
    // 1 millinewton / 1 kilogram = 1e-3 m/s^2 = 1 mm/s^2
    // UNITS ARE CORRECT.

    float accel_mm_s2 = force_mN / mass_kg; // mN/kg = mm/s^2
    float expected_mm_s2 = 1.0f / (p.piece_mass_g * 1e-3f);
    EXPECT(fabsf(accel_mm_s2 - expected_mm_s2) < 1.0f) PASS;
  } END_TEST

  TEST("Friction force units: mu * mN = mN") {
    float fric = p.mu_kinetic * weight_mN;
    // 0.45 * 42.18 = 18.98 mN
    EXPECT(fabsf(fric - p.mu_kinetic * p.piece_mass_g * 9.81f) < 0.01f) PASS;
  } END_TEST

  TEST("Stopping distance units: (mm/s)^2 / (2 * mm/s^2) = mm") {
    float v = p.target_velocity_mm_s;
    float friction_decel = p.mu_kinetic * weight_mN / mass_kg; // mN/kg = mm/s^2
    float stop_dist = v * v / (2.0f * friction_decel);
    printf("\n    v=%.0fmm/s decel=%.0fmm/s^2 stop=%.1fmm\n    ", v, friction_decel, stop_dist);
    EXPECT(stop_dist > 0 && stop_dist < 1000) PASS;
  } END_TEST

  TEST("GRID_TO_MM = 12.667mm (38mm board / 3 grid units)") {
    EXPECT(fabsf(GRID_TO_MM - 12.6667f) < 0.01f) PASS;
  } END_TEST
}

// --- 2. Analytical cross-checks ---
void test_analytical_physics() {
  printf("\n=== Analytical Physics Cross-Checks ===\n");

  PhysicsParams p = tunedParams();
  float mass_kg = p.piece_mass_g * 1e-3f;
  float weight_mN = p.piece_mass_g * 9.81f;

  TEST("Kinematic: v^2 = 2*a*d for constant acceleration") {
    // If we apply constant net force, piece should follow kinematics
    float net_force_mN = 20.0f; // mN
    float a = net_force_mN / mass_kg; // mm/s^2
    float d = 10.0f; // mm
    float v_expected = sqrtf(2.0f * a * d);

    // Simulate: apply constant force for distance d
    float v = 0, x = 0;
    float dt = 0.0001f;
    int ticks = 0;
    while (x < d && ticks < 1000000) {
      v += a * dt;
      x += v * dt;
      ticks++;
    }
    float err_pct = fabsf(v - v_expected) / v_expected * 100;
    printf("\n    analytical=%.2f sim=%.2f err=%.2f%%\n    ", v_expected, v, err_pct);
    EXPECT(err_pct < 1.0f) PASS;
  } END_TEST

  TEST("Friction-only deceleration: v^2 = v0^2 - 2*mu*g*d") {
    float v0 = 300.0f; // mm/s
    float mu = p.mu_kinetic;
    float g_mm = 9810.0f; // mm/s^2
    // Friction decel = mu * (weight) / mass = mu * g * 1000 (converting m->mm)
    float decel = mu * g_mm; // mm/s^2
    float d_analytical = v0 * v0 / (2.0f * decel);

    // Simulate coast
    float v = v0, x = 0;
    float dt_sim = 0.0001f;
    while (v > 0.1f) {
      float fric_a = decel;
      v -= fric_a * dt_sim;
      if (v < 0) v = 0;
      x += v * dt_sim;
    }
    float err_pct = fabsf(x - d_analytical) / d_analytical * 100;
    printf("\n    analytical=%.2fmm sim=%.2fmm err=%.2f%%\n    ", d_analytical, x, err_pct);
    EXPECT(err_pct < 1.0f) PASS;
  } END_TEST

  TEST("Coast stopping distance with Fz-enhanced friction") {
    // When coasting, Fz from coil increases normal force -> more friction -> shorter stop
    float v0 = 300.0f;
    float fz_center = -101.0f; // mN at 1A
    float normal_no_fz = weight_mN;
    float normal_with_fz = weight_mN + fabsf(fz_center) * p.max_current_a;

    float decel_no_fz = p.mu_kinetic * normal_no_fz / mass_kg;
    float decel_with_fz = p.mu_kinetic * normal_with_fz / mass_kg;

    float stop_no_fz = v0 * v0 / (2.0f * decel_no_fz);
    float stop_with_fz = v0 * v0 / (2.0f * decel_with_fz);

    printf("\n    no_fz: decel=%.0f stop=%.1fmm | with_fz: decel=%.0f stop=%.1fmm\n    ",
           decel_no_fz, stop_no_fz, decel_with_fz, stop_with_fz);

    // Coast in firmware uses weight-only normal (Fz=0 because coils off)
    // This is correct because during coast, current=0 so Fz contribution is 0
    printf("    NOTE: Coast uses weight-only friction (current=0 -> Fz=0)\n    ");
    EXPECT(stop_no_fz > stop_with_fz) PASS;
  } END_TEST

  TEST("Max achievable acceleration at peak force") {
    float peak_force = 54.0f * p.max_current_a; // mN at peak distance, layer 0
    float fric_force = p.mu_kinetic * (weight_mN + 101.0f * p.max_current_a); // max friction with Fz
    float net = peak_force - fric_force;
    float max_accel = net / mass_kg;
    printf("\n    peak_force=%.1fmN friction=%.1fmN net=%.1fmN accel=%.0fmm/s^2\n    ",
           peak_force, fric_force, net, max_accel);
    if (net <= 0) {
      reportIssue("WARNING", "physics", "Peak lateral force (%.1fmN) < friction (%.1fmN) at layer 0 with Fz!",
                  peak_force, fric_force);
    }
    // Even if net is negative with Fz, piece can still move because it won't be at center of coil
    EXPECT(true) PASS;
  } END_TEST
}

// --- 3. PWM compensation verification ---
void test_pwm_compensation() {
  printf("\n=== PWM Compensation ===\n");

  TEST("comp=0: raw_duty == eff_duty") {
    float comp = 0.0f;
    for (int raw = 0; raw <= 255; raw += 51) {
      float eff = raw + (255.0f - raw) * comp;
      EXPECT(fabsf(eff - raw) < 0.01f);
    }
    PASS;
  } END_TEST

  TEST("comp=0.2: minimum effective duty is 51 (20% of 255)") {
    float comp = 0.2f;
    float raw = 0;
    float eff = raw + (255.0f - raw) * comp;
    printf("\n    raw=0 -> eff=%.1f (%.0f%% of 255)\n    ", eff, eff/255*100);
    EXPECT(fabsf(eff - 51.0f) < 1.0f) PASS;
  } END_TEST

  TEST("comp=0.2: raw=255 -> eff=255 (full duty)") {
    float comp = 0.2f;
    float raw = 255.0f;
    float eff = raw + (255.0f - raw) * comp;
    EXPECT(fabsf(eff - 255.0f) < 0.01f) PASS;
  } END_TEST

  TEST("Inverse PWM: desired_eff -> raw -> eff round-trips") {
    float comp = 0.2f;
    for (float desired_eff = 51; desired_eff <= 255; desired_eff += 20) {
      float raw = (desired_eff - 255.0f * comp) / (1.0f - comp);
      if (raw < 0) raw = 0;
      if (raw > 255) raw = 255;
      uint8_t raw_byte = (uint8_t)raw;
      float actual_eff = raw_byte + (255.0f - raw_byte) * comp;
      float err = fabsf(actual_eff - desired_eff);
      // Quantization error from uint8_t can be up to ~1.25 effective units
      EXPECT(err < 2.0f);
    }
    PASS;
  } END_TEST

  TEST("comp=0.99: raw_duty is always 0 (branch guard)") {
    float comp = 0.99f;
    float raw = (comp < 0.99f) ? (128.0f - 255.0f * comp) / (1.0f - comp) : 0;
    EXPECT(raw == 0) PASS;
  } END_TEST

  TEST("Negative raw_duty clamped to 0") {
    // When desired current is very low, raw could go negative
    float comp = 0.2f;
    float desired_eff = 30.0f; // below the minimum (51)
    float raw = (desired_eff - 255.0f * comp) / (1.0f - comp);
    printf("\n    desired_eff=%.0f -> raw=%.1f (clamped to 0)\n    ", desired_eff, raw);
    EXPECT(raw < 0) PASS; // confirms clamping is needed
  } END_TEST
}

// --- 4. Jerk limiting ---
void test_jerk_limiting() {
  printf("\n=== Jerk Limiting ===\n");

  TEST("Acceleration ramps up smoothly with jerk limit") {
    PhysicsParams p = tunedParams();
    float dt = 0.01f;
    float max_da = p.max_jerk_mm_s3 * dt; // 20000 * 0.01 = 200 mm/s^2 per tick

    float last_accel = 0;
    std::vector<float> accels;

    // Simulate 20 ticks of demanding full accel
    for (int i = 0; i < 20; i++) {
      float desired = p.target_accel_mm_s2; // 1500
      float da = desired - last_accel;
      if (da > max_da) desired = last_accel + max_da;
      else if (da < -max_da) desired = last_accel - max_da;
      last_accel = desired;
      accels.push_back(desired);
    }

    // Should ramp: 200, 400, 600... up to 1500
    int ticks_to_full = (int)ceilf(p.target_accel_mm_s2 / max_da);
    printf("\n    ticks to full accel: %d (expected %d)\n    ", ticks_to_full, ticks_to_full);

    // Verify monotonically increasing
    bool monotonic = true;
    for (size_t i = 1; i < accels.size() && accels[i-1] < p.target_accel_mm_s2; i++) {
      if (accels[i] < accels[i-1] - 0.01f) { monotonic = false; break; }
    }
    EXPECT(monotonic) PASS;
  } END_TEST

  TEST("Jerk limit constrains acceleration change per tick") {
    PhysicsParams p = tunedParams();
    float dt = 0.01f;
    float max_da = p.max_jerk_mm_s3 * dt;

    float last_accel = 0;
    float desired = 5000.0f; // way above target_accel

    float clamped = fminf(fmaxf(desired, -p.target_accel_mm_s2), p.target_accel_mm_s2);
    float da = clamped - last_accel;
    if (da > max_da) clamped = last_accel + max_da;

    printf("\n    desired=5000 -> clamped_by_accel=%.0f -> clamped_by_jerk=%.0f\n    ",
           p.target_accel_mm_s2, clamped);
    EXPECT(clamped <= max_da + 0.01f) PASS;
  } END_TEST
}

// --- 5. Coast and stopping ---
void test_coast_stopping() {
  printf("\n=== Coast & Stopping Behavior ===\n");

  TEST("Coast triggers when stopping_dist >= dist_remain") {
    PhysicsParams p = tunedParams();
    float mass_kg = p.piece_mass_g * 1e-3f;
    float weight_mN = p.piece_mass_g * 9.81f;

    // At v=300mm/s, friction-only decel
    float coast_mu = p.mu_kinetic + p.coast_friction_offset;
    float friction_decel = coast_mu * weight_mN / mass_kg;
    float stop_dist = 300.0f * 300.0f / (2.0f * friction_decel);

    printf("\n    friction_decel=%.0fmm/s^2 stop_dist=%.1fmm\n    ", friction_decel, stop_dist);
    // For a 1-coil move (12.67mm), coast should trigger early
    EXPECT(stop_dist > 0) PASS;
  } END_TEST

  TEST("1-step move: piece arrives (or overshoots due to coast bug)") {
    PhysicsParams p = tunedParams();
    PieceState piece;
    piece.reset(0, 0);

    float path[1][2] = {{ 0, GRID_TO_MM }};
    SimResult r = simulateFirmwarePhysics(piece, path, 1, p);
    printf("\n    final=(%.1f,%.1f) err=%d t=%.0fms coasted=%d\n    ",
           r.final_x, r.final_y, (int)r.error, r.elapsed_ms, r.coasted);
    if (r.error != MoveError::NONE) {
      reportIssue("NOTE", "coast-bug-effect",
                  "1-step move fails: piece at (%.1f,%.1f) — likely due to coast friction bug causing overshoot",
                  r.final_x, r.final_y);
    }
    // Don't hard-fail — this is expected consequence of the coast-friction bug
    EXPECT(!std::isnan(r.final_x) && !std::isnan(r.final_y)) PASS;
  } END_TEST

  TEST("3-step move: piece moves and coasts (may overshoot)") {
    PhysicsParams p = tunedParams();
    PieceState piece;
    piece.reset(0, 0);

    float path[3][2] = {
      { 0, 1 * GRID_TO_MM },
      { 0, 2 * GRID_TO_MM },
      { 0, 3 * GRID_TO_MM },
    };
    SimResult r = simulateFirmwarePhysics(piece, path, 3, p);
    float target = 3 * GRID_TO_MM;
    float overshoot = r.final_y - target;
    printf("\n    final=(%.1f,%.1f) target=%.1f overshoot=%.1fmm v=(%.1f,%.1f) t=%.0fms max_v=%.0f coasted=%d\n    ",
           r.final_x, r.final_y, target, overshoot, r.final_vx, r.final_vy, r.elapsed_ms, r.max_speed, r.coasted);
    if (overshoot > 5.0f) {
      reportIssue("BUG", "overshoot",
                  "3-step move overshoots by %.1fmm (coast-friction bug causes zero deceleration near dest coil)",
                  overshoot);
    }
    // Piece should at least have moved in the right direction
    EXPECT(r.final_y > 10.0f) PASS;
  } END_TEST

  TEST("coast_friction_offset increases braking (shorter stop)") {
    PhysicsParams p1 = tunedParams();
    PhysicsParams p2 = tunedParams();
    p2.coast_friction_offset = 0.2f;

    float mass_kg = p1.piece_mass_g * 1e-3f;
    float weight_mN = p1.piece_mass_g * 9.81f;

    float decel1 = (p1.mu_kinetic + p1.coast_friction_offset) * weight_mN / mass_kg;
    float decel2 = (p2.mu_kinetic + p2.coast_friction_offset) * weight_mN / mass_kg;
    float stop1 = 300.0f * 300.0f / (2.0f * decel1);
    float stop2 = 300.0f * 300.0f / (2.0f * decel2);

    printf("\n    offset=0: stop=%.1fmm | offset=0.2: stop=%.1fmm\n    ", stop1, stop2);
    EXPECT(stop2 < stop1) PASS;
  } END_TEST
}

// --- 6. Force table sanity ---
void test_force_model_sanity() {
  printf("\n=== Force Model Sanity ===\n");

  TEST("Force is zero at coil center (d=0)") {
    float fx = stubForceFx(0, 0, 0);
    float fy = stubForceFy(0, 0, 0);
    EXPECT(fabsf(fx) < 0.01f && fabsf(fy) < 0.01f) PASS;
  } END_TEST

  TEST("Fz is negative (pulls down) at center") {
    float fz = stubForceFz(0, 0, 0);
    EXPECT(fz < -50.0f) PASS;
  } END_TEST

  TEST("Force points toward coil center") {
    // Piece at +5mm from coil -> force should be negative (toward coil)
    float fx = stubForceFx(0, 5.0f, 0);
    EXPECT(fx < 0) PASS;
    // Piece at -5mm -> force should be positive
    float fx2 = stubForceFx(0, -5.0f, 0);
    EXPECT(fx2 > 0) PASS;
  } END_TEST

  TEST("Force falls off at large distance (past peak)") {
    float f10 = stubForceHMag(0, 10.0f);
    float f20 = stubForceHMag(0, 20.0f);
    float f30 = stubForceHMag(0, 30.0f);
    EXPECT(f10 > f20 && f20 > f30) PASS;
  } END_TEST

  TEST("Deeper layers have weaker forces") {
    float f0 = stubForceHMag(0, 5.0f);
    float f1 = stubForceHMag(1, 5.0f);
    float f2 = stubForceHMag(2, 5.0f);
    float f4 = stubForceHMag(4, 5.0f);
    printf("\n    L0=%.1f L1=%.1f L2=%.1f L4=%.1f mN\n    ", f0, f1, f2, f4);
    EXPECT(f0 > f1 && f1 > f2 && f2 > f4) PASS;
  } END_TEST

  TEST("Force at coil spacing (~12.67mm) > kinetic friction (tuned params, L0)") {
    PhysicsParams p = tunedParams();
    float f = stubForceHMag(0, GRID_TO_MM) * p.max_current_a;
    float fric = p.mu_kinetic * p.piece_mass_g * 9.81f;
    printf("\n    force=%.1fmN friction=%.1fmN\n    ", f, fric);
    if (f <= fric) {
      reportIssue("WARNING", "force", "Layer 0 force at spacing (%.1fmN) <= friction (%.1fmN)", f, fric);
    }
    EXPECT(true) PASS;
  } END_TEST
}

// --- 7. Edge cases and fuzz ---
void test_edge_cases() {
  printf("\n=== Edge Cases ===\n");

  TEST("Zero-length path returns error") {
    PieceState piece; piece.reset(0,0);
    PhysicsParams p;
    float path[1][2] = {{0,0}};
    SimResult r = simulateFirmwarePhysics(piece, path, 0, p);
    EXPECT(r.error == MoveError::COIL_FAILURE) PASS;
  } END_TEST

  TEST("Zero mass returns error") {
    PieceState piece; piece.reset(0,0);
    PhysicsParams p; p.piece_mass_g = 0;
    float path[1][2] = {{0, GRID_TO_MM}};
    SimResult r = simulateFirmwarePhysics(piece, path, 1, p);
    EXPECT(r.error == MoveError::COIL_FAILURE) PASS;
  } END_TEST

  TEST("Zero current returns error") {
    PieceState piece; piece.reset(0,0);
    PhysicsParams p; p.max_current_a = 0;
    float path[1][2] = {{0, GRID_TO_MM}};
    SimResult r = simulateFirmwarePhysics(piece, path, 1, p);
    EXPECT(r.error == MoveError::COIL_FAILURE) PASS;
  } END_TEST

  TEST("Zero velocity target returns error") {
    PieceState piece; piece.reset(0,0);
    PhysicsParams p; p.target_velocity_mm_s = 0;
    float path[1][2] = {{0, GRID_TO_MM}};
    SimResult r = simulateFirmwarePhysics(piece, path, 1, p);
    EXPECT(r.error == MoveError::COIL_FAILURE) PASS;
  } END_TEST

  TEST("Very small mass (0.1g) doesn't cause overflow") {
    PieceState piece; piece.reset(0,0);
    PhysicsParams p; p.piece_mass_g = 0.1f;
    float path[1][2] = {{0, GRID_TO_MM}};
    SimResult r = simulateFirmwarePhysics(piece, path, 1, p);
    printf("\n    final=(%.1f,%.1f) max_speed=%.0f err=%d\n    ",
           r.final_x, r.final_y, r.max_speed, (int)r.error);
    EXPECT(!std::isnan(r.final_x) && !std::isnan(r.final_y) && !std::isinf(r.max_speed)) PASS;
  } END_TEST

  TEST("Very high friction (mu=5) times out without NaN") {
    PieceState piece; piece.reset(0,0);
    PhysicsParams p; p.mu_static = 5.0f; p.mu_kinetic = 4.0f; p.max_duration_ms = 500;
    float path[1][2] = {{0, GRID_TO_MM}};
    SimResult r = simulateFirmwarePhysics(piece, path, 1, p);
    EXPECT(!std::isnan(r.final_x) && !std::isnan(r.final_y)) PASS;
  } END_TEST

  TEST("Negative move direction: piece moves in -y") {
    PieceState piece; piece.reset(0, 3 * GRID_TO_MM);
    PhysicsParams p = tunedParams();
    float path[3][2] = {
      { 0, 2 * GRID_TO_MM },
      { 0, 1 * GRID_TO_MM },
      { 0, 0 },
    };
    SimResult r = simulateFirmwarePhysics(piece, path, 3, p);
    printf("\n    final=(%.1f,%.1f) err=%d t=%.0fms\n    ",
           r.final_x, r.final_y, (int)r.error, r.elapsed_ms);
    // Piece should move downward (may not arrive due to coast bug)
    EXPECT(r.final_y < 3 * GRID_TO_MM - 5.0f) PASS;
  } END_TEST
}

// --- 8. Parameter fuzz ---
void test_parameter_fuzz() {
  printf("\n=== Parameter Fuzz (randomized) ===\n");

  std::mt19937 rng(42); // fixed seed for reproducibility

  auto randFloat = [&](float lo, float hi) -> float {
    return std::uniform_real_distribution<float>(lo, hi)(rng);
  };

  int total = 200;
  int succeeded = 0;
  int timed_out = 0;
  int nan_count = 0;
  int inf_count = 0;
  int stuck_count = 0;
  int reversed_count = 0;

  for (int i = 0; i < total; i++) {
    PhysicsParams p;
    p.piece_mass_g = randFloat(0.5f, 20.0f);
    p.max_current_a = randFloat(0.1f, 3.0f);
    p.mu_static = randFloat(0.05f, 2.0f);
    p.mu_kinetic = randFloat(0.05f, fminf(p.mu_static, 1.5f));
    p.target_velocity_mm_s = randFloat(10.0f, 1000.0f);
    p.target_accel_mm_s2 = randFloat(100.0f, 5000.0f);
    p.max_jerk_mm_s3 = randFloat(1000.0f, 100000.0f);
    p.coast_friction_offset = randFloat(-0.1f, 0.5f);
    p.brake_pulse_ms = (uint16_t)randFloat(0, 200);
    p.pwm_compensation = randFloat(0.0f, 0.5f);
    p.force_scale = randFloat(0.3f, 3.0f);
    p.max_duration_ms = 3000;

    PieceState piece;
    piece.reset(0, 0);

    int steps = (int)randFloat(1, 6);
    float path[6][2];
    for (int s = 0; s < steps; s++) {
      path[s][0] = 0;
      path[s][1] = (s + 1) * GRID_TO_MM;
    }

    SimResult r = simulateFirmwarePhysics(piece, path, steps, p);

    if (std::isnan(r.final_x) || std::isnan(r.final_y) || std::isnan(r.max_speed)) {
      nan_count++;
      reportIssue("BUG", "fuzz-nan", "NaN detected with params: mass=%.1f I=%.1f mu_s=%.2f mu_k=%.2f v=%.0f",
                  p.piece_mass_g, p.max_current_a, p.mu_static, p.mu_kinetic, p.target_velocity_mm_s);
    }
    if (std::isinf(r.final_x) || std::isinf(r.final_y) || std::isinf(r.max_speed)) {
      inf_count++;
      reportIssue("BUG", "fuzz-inf", "Inf detected with params: mass=%.1f I=%.1f mu_s=%.2f mu_k=%.2f v=%.0f",
                  p.piece_mass_g, p.max_current_a, p.mu_static, p.mu_kinetic, p.target_velocity_mm_s);
    }
    if (r.error == MoveError::NONE) {
      succeeded++;
    } else {
      timed_out++;
      // Check if piece moved at all
      if (fabsf(r.final_y) < 0.1f) stuck_count++;
      // Check if piece went wrong direction
      if (r.final_y < -1.0f) {
        reversed_count++;
        reportIssue("BUG", "fuzz-reverse", "Piece reversed! final_y=%.1f with mass=%.1f I=%.1f mu_s=%.2f",
                    r.final_y, p.piece_mass_g, p.max_current_a, p.mu_static);
      }
    }
  }

  printf("\n  Fuzz results (%d trials):\n", total);
  printf("    Succeeded:  %d (%.0f%%)\n", succeeded, succeeded * 100.0f / total);
  printf("    Timed out:  %d (%.0f%%)\n", timed_out, timed_out * 100.0f / total);
  printf("    Stuck:      %d\n", stuck_count);
  printf("    Reversed:   %d\n", reversed_count);
  printf("    NaN:        %d\n", nan_count);
  printf("    Inf:        %d\n", inf_count);

  TEST("No NaN values in any fuzz run") {
    EXPECT(nan_count == 0) PASS;
  } END_TEST

  TEST("No Inf values in any fuzz run") {
    EXPECT(inf_count == 0) PASS;
  } END_TEST

  TEST("No reversed movement in any fuzz run") {
    EXPECT(reversed_count == 0) PASS;
  } END_TEST

  TEST("No catastrophic failures (NaN/Inf/reverse) in any fuzz run") {
    printf("\n    success rate: %.0f%% (low is OK — random params often can't overcome friction)\n    ",
           succeeded * 100.0f / total);
    EXPECT(nan_count == 0 && inf_count == 0 && reversed_count == 0) PASS;
  } END_TEST
}

// --- 9. Firmware-vs-test divergence audit ---
void test_firmware_divergence() {
  printf("\n=== Firmware vs Test Code Divergence ===\n");

  // Check that our existing test_physics.cpp is missing features from firmware
  printf("  Known divergences between test_physics.cpp and firmware physics.h:\n");

  TEST("test_physics.cpp PhysicsParams is missing fields") {
    // The existing test file's PhysicsParams has active_brake (bool) instead of:
    // max_jerk_mm_s3, coast_friction_offset, brake_pulse_ms, pwm_freq_hz,
    // pwm_compensation, all_coils_equal, force_scale
    printf("\n");
    printf("    MISSING: max_jerk_mm_s3 (jerk limiting)\n");
    printf("    MISSING: coast_friction_offset\n");
    printf("    MISSING: brake_pulse_ms (centering pulse)\n");
    printf("    MISSING: pwm_freq_hz\n");
    printf("    MISSING: pwm_compensation\n");
    printf("    MISSING: all_coils_equal\n");
    printf("    MISSING: force_scale\n");
    printf("    HAS: active_brake (not in firmware)\n");
    reportIssue("WARNING", "divergence",
                "test_physics.cpp PhysicsParams is out of sync with firmware — 7 missing fields, 1 stale field");
    EXPECT(true) PASS;
  } END_TEST

  TEST("test_physics.cpp PieceState field names differ") {
    // Firmware: x, y, vx, vy
    // Test: x_mm, y_mm, vx_mm_s, vy_mm_s
    printf("\n");
    printf("    firmware: x, y, vx, vy\n");
    printf("    test:     x_mm, y_mm, vx_mm_s, vy_mm_s\n");
    reportIssue("NOTE", "divergence", "PieceState field names differ (cosmetic but could cause confusion)");
    EXPECT(true) PASS;
  } END_TEST

  TEST("test_physics.cpp simulation loop is missing features") {
    printf("\n");
    printf("    MISSING: jerk limiting\n");
    printf("    MISSING: PWM compensation (duty calculation)\n");
    printf("    MISSING: coast_friction_offset in stopping calc\n");
    printf("    MISSING: centering pulse logic\n");
    printf("    MISSING: force_scale multiplier\n");
    printf("    MISSING: layer-dependent forces\n");
    printf("    DIFFERENT: coast only checks on last coil (firmware checks every tick)\n");
    reportIssue("WARNING", "divergence",
                "test_physics.cpp simulation misses 6+ firmware features — results may not match hardware");
    EXPECT(true) PASS;
  } END_TEST
}

// --- 10. Velocity profile analysis ---
void test_velocity_profiles() {
  printf("\n=== Velocity Profile Analysis ===\n");

  TEST("3-step move: velocity profile analysis") {
    PhysicsParams p = tunedParams();
    PieceState piece;
    piece.reset(0, 0);

    float path[3][2] = {
      { 0, 1 * GRID_TO_MM },
      { 0, 2 * GRID_TO_MM },
      { 0, 3 * GRID_TO_MM },
    };

    SimResult r = simulateFirmwarePhysics(piece, path, 3, p, true);

    // Check peak speed reached reasonable fraction of target
    // (may not reach full target on short moves)

    // Check no sudden velocity jumps > 2x jerk limit
    float max_dv = 0;
    for (size_t i = 1; i < r.speed_history.size(); i++) {
      float dv = fabsf(r.speed_history[i] - r.speed_history[i-1]);
      if (dv > max_dv) max_dv = dv;
    }
    float max_allowed_dv = p.target_accel_mm_s2 * 0.01f * 1.5f; // accel * dt * safety margin
    printf("\n    max_dv=%.1f allowed=%.1f peak_speed=%.0f t=%.0fms\n    ",
           max_dv, max_allowed_dv, r.max_speed, r.elapsed_ms);

    if (max_dv > max_allowed_dv) {
      reportIssue("WARNING", "velocity", "Speed jump of %.1fmm/s exceeds expected max of %.1fmm/s",
                  max_dv, max_allowed_dv);
    }
    PASS;
  } END_TEST

  TEST("6-step move (full board): reasonable timing") {
    PhysicsParams p = tunedParams();
    PieceState piece;
    piece.reset(0, 0);

    float path[6][2];
    for (int i = 0; i < 6; i++) { path[i][0] = 0; path[i][1] = (i+1) * GRID_TO_MM; }

    SimResult r = simulateFirmwarePhysics(piece, path, 6, p);
    float dist = 6 * GRID_TO_MM;
    float avg_speed = (r.elapsed_ms > 0) ? dist / (r.elapsed_ms / 1000.0f) : 0;

    printf("\n    dist=%.0fmm t=%.0fms avg=%.0fmm/s max=%.0fmm/s switches=%d err=%d\n    ",
           dist, r.elapsed_ms, avg_speed, r.max_speed, r.coil_switches, (int)r.error);

    if (r.error == MoveError::NONE) {
      // Average speed should be somewhat reasonable
      EXPECT(avg_speed > 20.0f && avg_speed < 2000.0f) PASS;
    } else {
      reportIssue("WARNING", "timing", "6-step move timed out! last_pos=(%.1f,%.1f)",
                  r.final_x, r.final_y);
      EXPECT(true) PASS;
    }
  } END_TEST
}

// --- 11. Specific bug scenarios ---
void test_known_bug_scenarios() {
  printf("\n=== Known Bug Scenario Regression ===\n");

  TEST("Friction can't reverse velocity (the original bug)") {
    PhysicsParams p = tunedParams();
    float mass_kg = p.piece_mass_g * 1e-3f;
    float dt = 0.01f;

    // Piece barely moving
    float speed = 0.5f; // mm/s
    float weight_mN = p.piece_mass_g * 9.81f;
    float normal_mN = weight_mN + 101.0f * p.max_current_a; // worst case Fz
    float fric = p.mu_kinetic * fmaxf(normal_mN, 0);
    float max_fric = speed / dt * mass_kg;
    if (fric > max_fric) fric = max_fric;

    float vy = speed;
    vy -= (fric / mass_kg) * dt;

    printf("\n    v_before=%.2f v_after=%.4f fric=%.1f max_fric=%.4f\n    ",
           speed, vy, p.mu_kinetic * normal_mN, max_fric);
    EXPECT(vy >= -0.001f) PASS;
  } END_TEST

  TEST("BUG: Coast friction uses stale last_current -> zero friction near coils") {
    // During coast, coils are off (current=0), but last_current retains pre-coast value.
    // Friction calculation: normal_mN = weight_mN + fz_1a * last_current
    // Near a coil center, fz is large negative (e.g., -101mN at 1A).
    // With last_current=1.2A: normal = 42.18 + (-101)*1.2 = 42.18 - 121.2 = -79 mN
    // Clamped to 0 -> ZERO friction -> piece never decelerates!
    //
    // Far from coil: fz is small -> normal stays positive -> extra friction
    // Near coil center: fz dominates -> normal goes negative -> NO friction
    //
    // This explains why pieces overshoot: coast triggers at correct distance,
    // but as piece approaches destination coil, friction drops to zero.

    PhysicsParams p = tunedParams();
    float mass_kg = p.piece_mass_g * 1e-3f;
    float weight_mN = p.piece_mass_g * 9.81f;

    // At coil center (worst case)
    float fz_center = stubForceFz(0, 0, 0); // ~ -101 mN at 1A
    float normal_stale = weight_mN + fz_center * p.max_current_a;
    printf("\n    fz_at_center=%.1f mN/A\n", fz_center);
    printf("    normal with stale current: %.1f + (%.1f * %.1f) = %.1f mN (clamped to 0)\n",
           weight_mN, fz_center, p.max_current_a, normal_stale);
    printf("    normal with correct current=0: %.1f mN\n", weight_mN);

    // Show the problem: at various distances from destination coil
    printf("    Distance from dest coil -> normal force:\n");
    for (float d = 15; d >= 0; d -= 3) {
      float fz = stubForceFz(0, d, 0);
      float norm_buggy = fmaxf(weight_mN + fz * p.max_current_a, 0.0f);
      float norm_correct = weight_mN; // no current during coast
      printf("      d=%4.0fmm: buggy=%.1fmN correct=%.1fmN friction_ratio=%.0f%%\n",
             d, norm_buggy, norm_correct, norm_buggy / norm_correct * 100);
    }

    reportIssue("BUG", "coast-friction",
                "During coast, last_current is stale (not reset to 0). "
                "Near coil centers fz*I makes normal_mN negative -> clamped to 0 -> zero friction -> piece overshoots. "
                "Fix: add 'last_current = 0;' when entering coast mode (line ~168 in physics.h).");
    EXPECT(normal_stale < 0) PASS; // confirms the bug exists
  } END_TEST

  TEST("PWM compensation minimum current floor") {
    // With comp=0.2, the minimum effective duty is 51/255 = 20%.
    // This means you can NEVER set current below 20% of max.
    // If the controller wants 5% current, it gets 20%.
    PhysicsParams p = tunedParams();
    float comp = p.pwm_compensation;
    float min_current_pct = comp * 100;
    printf("\n    PWM comp=%.1f -> minimum current=%.0f%% of max (%.2fA)\n    ",
           comp, min_current_pct, p.max_current_a * comp);

    if (min_current_pct > 30) {
      reportIssue("WARNING", "pwm", "PWM compensation %.1f creates %.0f%% minimum current floor",
                  comp, min_current_pct);
    }
    EXPECT(true) PASS;
  } END_TEST

  TEST("Coil switching threshold too tight (0.1mm)") {
    // Firmware uses 0.1mm past coil center to trigger switch.
    // At 300mm/s with 10ms ticks, piece moves 3mm per tick.
    // It will be ~3mm past when detected, reducing force from next coil.
    PhysicsParams p = tunedParams();
    float advance_per_tick = p.target_velocity_mm_s * 0.01f; // mm at 10ms ticks
    printf("\n    advance_per_tick=%.1fmm (threshold=0.1mm)\n    ", advance_per_tick);

    if (advance_per_tick > 2.0f) {
      reportIssue("NOTE", "coil-switch",
                  "At %.0fmm/s, piece advances %.1fmm per 10ms tick but switch threshold is 0.1mm. "
                  "Piece will typically be ~%.1fmm past coil center when switch happens. "
                  "Consider switching BEFORE reaching coil center for smoother handoff.",
                  p.target_velocity_mm_s, advance_per_tick, advance_per_tick / 2);
    }
    EXPECT(true) PASS;
  } END_TEST
}

// --- 12. Centering pulse analysis ---
void test_centering_pulse() {
  printf("\n=== Centering Pulse Analysis ===\n");

  TEST("Centering pulse fires during coast when near dest and slow") {
    PhysicsParams p = tunedParams();
    PieceState piece;
    piece.reset(0, 0);

    float path[1][2] = {{ 0, GRID_TO_MM }};
    SimResult r = simulateFirmwarePhysics(piece, path, 1, p);
    printf("\n    centered=%d coasted=%d err=%d final=(%.1f,%.1f) t=%.0fms\n    ",
           r.centered, r.coasted, (int)r.error, r.final_x, r.final_y, r.elapsed_ms);
    // Centering pulse may or may not fire depending on coast behavior (affected by coast-friction bug)
    EXPECT(!std::isnan(r.final_x)) PASS;
  } END_TEST

  TEST("brake_pulse_ms=0 skips centering pulse") {
    PhysicsParams p = tunedParams();
    p.brake_pulse_ms = 0;
    PieceState piece;
    piece.reset(0, 0);

    float path[1][2] = {{ 0, GRID_TO_MM }};
    SimResult r = simulateFirmwarePhysics(piece, path, 1, p);
    EXPECT(!r.centered) PASS;
  } END_TEST
}

// ═══════════════════════════════════════════════════════════════
// Main
// ═══════════════════════════════════════════════════════════════

int main(int argc, char** argv) {
  for (int i = 1; i < argc; i++) {
    if (strcmp(argv[i], "-v") == 0) g_verbosity = 1;
    else if (strcmp(argv[i], "-vv") == 0) g_verbosity = 2;
  }

  printf("FluxChess Physics Verification & Fuzz Suite\n");
  printf("============================================\n");

  test_unit_consistency();
  test_analytical_physics();
  test_pwm_compensation();
  test_jerk_limiting();
  test_coast_stopping();
  test_force_model_sanity();
  test_edge_cases();
  test_parameter_fuzz();
  test_firmware_divergence();
  test_velocity_profiles();
  test_known_bug_scenarios();
  test_centering_pulse();

  printf("\n============================================\n");
  printf("Results: %d passed, %d failed\n", tests_passed, tests_failed);

  if (!issues.empty()) {
    printf("\n============================================\n");
    printf("ISSUES FOUND (%zu):\n", issues.size());
    printf("============================================\n");
    for (size_t i = 0; i < issues.size(); i++) {
      printf("  %zu. [%s] %s: %s\n", i+1, issues[i].severity.c_str(),
             issues[i].category.c_str(), issues[i].description.c_str());
    }
  }

  printf("\n");
  return tests_failed > 0 ? 1 : 0;
}
