LeadFreeCandy/Flux-Chess/(commit log)

2025-04-24 Initial commit, add PCB Coil calculator
2026-03-17 Scaffold firmware directory and partition table
    [partitions.csv]
2026-03-17 Add api.h — API type definitions and command table
2026-03-17 Add codegen script — generates TypeScript from api.h
2026-03-17 Add transport layer — HTTP and WebSerial with auto-detection
2026-03-17 Add transport layer — HTTP routes and serial JSON dispatch
2026-03-17 Add firmware.ino — WiFi, LittleFS, server, serial loop
2026-03-17 Add dashboard UI — board state, pulse coil, RGB, shutdown
2026-03-17 Fix firmware: single-file architecture, working serial API
    - Move all handler and dispatch code into firmware.ino to avoid
    Arduino builder auto-linking separate .cpp files (which pulled
    in WiFi/AsyncWebServer and caused crashes)
    - Shrink partition table to fit 4MB (2MB app + 2MB SPIFFS)
    - Add -DESP32 build flag for ESPAsyncWebServer compatibility
    - All 4 serial API commands tested and working:
    pulse_coil, get_board_state, set_rgb, shutdown
    [partitions.csv]
2026-03-17 Fix serial transport: require user click for WebSerial connect
    Browser security requires requestPort() to be triggered by a user
    gesture. Show a Connect button in serial mode instead of auto-connecting.
2026-03-17 Fix serial transport: wait for ESP32 boot, add debug logging
    - Wait 2s after port open for ESP32 to reset and boot
    - Add console.log for TX/RX to help debug serial issues
    - Only resolve pending request when response has "result" field
2026-03-17 Fix: remove -DESP32 flag that broke USB CDC serial
    -DESP32 was added for ESPAsyncWebServer compatibility but it
    interferes with the ESP32-S3 USB CDC driver, causing Serial
    to produce no output. Removed the flag and switched to
    non-blocking char-by-char serial reading.
    All 4 API commands verified working over serial.
    [firmware.ino]
2026-03-17 Simplify firmware: drop ArduinoJson, remove broken build flags
    - Remove -DESP32 and empty -DWIFI_SSID/-DWIFI_PASSWORD flags that
    broke USB CDC serial on ESP32-S3
    - Replace ArduinoJson with inline JSON parsing/generation (zero deps)
    - Simplify dev_serial.sh: no hash caching, no extra build properties
    - Clean FQBN: just esp32:esp32:esp32s3:CDCOnBoot=cdc
    - All API commands verified working over both pyserial and WebSerial
    [firmware.ino]
2026-03-17 Refactor firmware into layered architecture
    - hardware.h: low-level driver (shift registers, ADC, touch buttons,
    DC sense, per-coil thermal tracking, shutdown)
    - board.h: high-level Board object wrapping Hardware (pulse coil,
    board state, RGB, buttons, power sense)
    - serial_server.h: JSON parsing, dispatch, response helpers
    - firmware.ino: 12-line glue file
    All header-only to avoid Arduino auto-compile issues.
    Same wire format — frontend unchanged.
    [board.h, firmware.ino, hardware.h, serial_server.h]
2026-03-17 Make command dispatch dynamic with registry pattern
    Commands register via serial.on("name", handler). Adding a new
    command is one line — no if/else chain to maintain. Handler functions
    are free functions reusable by future web server.
2026-03-17 SPI shift registers, toJson on all response types
    - hardware.h: replace bit-bang with ESP32 SPI (FSPI, 4MHz)
    - api.h: add toJson() to all response structs and enums, add Json
    builder helper class for painless JSON construction
    - serial_server.h: handlers now just call res.toJson(), no manual
    JSON string building per response type
    - Adding a new API endpoint: define struct with toJson(), write
    one handler function, register with serial.on()
    [api.h, hardware.h, serial_server.h]
2026-03-17 Move pulse logic to Hardware, Board delegates
    Hardware.pulseCoil(bit, duration) handles the full sequence:
    set SR bit, write, enable OE, delay, clear, disable OE, record thermal.
    Board validates grid coords and will map to coil bits once grid
    mapping table is populated.
2026-03-17 Auto-generate enum toJson with FLUX_ENUM macro
    FLUX_ENUM(Name, VAL1, VAL2, ...) defines both the enum class and
    its toJson() function. No more manual switch statements per enum.
2026-03-17 Add coil grid mapping, rename hw pulseCoil to pulseBit
    - Board.pulseCoil(x, y, dur) maps grid coords to SR bit via L-shaped
    coil layout: 12 SRs in 4×3 grid, each driving 5 coils (bits 0-4)
    - Hardware.pulseBit(globalBit, dur) rejects bits 5-7 per SR
    - Grid updated to 12×9 to match physical layout
    - Tested: valid L-shape positions, empty positions, cross-SR blocks
2026-03-17 Fix grid to 10x7 — last SR column/row are partial
    [api.h]
2026-03-17 Consolidate JSON utils into utils.h, auto-handle enum types
    - Rename macros.h → utils.h, move all JSON helpers there
    (Json builder, jsonGet, jsonGetObj, FLUX_ENUM)
    - Json::add() auto-detects FLUX_ENUM types via template overload
    — no more manual toJson(error) calls
    - api.h is now just types: enums, structs, one-liner toJson()
    - serial_server.h has no JSON utils, just handlers + dispatch
    - Removed request structs (unused — params parsed directly)
    [api.h, serial_server.h, utils.h]
2026-03-17 Redesign dashboard: 3D wireframe, 4x3 sensor grid, serial console
    - Board state is now 4x3 (12 hall sensors in a grid)
    - Wireframe 3D surface plot of magnetic field strengths
    - 10Hz polling with start/stop
    - Raw serial console showing all TX/RX
    - Dark theme, clean layout
    - Fixed codegen: restored request structs for proper param generation
    - Serial transport emits log events for the console
    [api.h, board.h]
2026-03-17 Add interactive 3D surface plot with Three.js
    - Bicubic interpolation for smooth surface between 4x3 grid points
    - Orbit controls: drag to rotate, scroll to zoom
    - Color gradient from blue (low) to red (high) with wireframe overlay
    - Replaces the broken canvas wireframe
2026-03-17 Add RGB LED support via neopixelWrite on GPIO 48
2026-03-17 Clear shift registers before neopixel write to prevent coil glitches
    Pin 48 is shared between SR OE and NeoPixel. The RMT peripheral
    toggles the pin during neopixelWrite(), which would flicker OE.
    Clearing SR state first ensures no coils fire during the glitch.
    [hardware.h]
2026-03-17 Fix duplicate serial logs, make surface plot horizontal
    - onSerialLog returns unsubscribe fn, useEffect cleanup prevents
    duplicate listeners from React StrictMode re-mounting
    - Rotate surface plane to lie flat (XZ plane, height on Y axis)
2026-03-17 Add interactive coil grid — click to pulse, L-shape layout highlighted
    10x7 grid showing all coil positions. Only actuable coils (L-shape
    pattern per SR block) are clickable. Replaces the X/Y number inputs.
2026-03-17 Add debug logging with frontend filter levels
    Firmware:
    - LOG_HW() and LOG_BOARD() macros emit JSON log messages on serial
    - Always logs at max verbosity, no firmware config needed
    Frontend console filter (4 levels):
    - All: hw + board + io + errors
    - Board+: board + io + errors (no hw)
    - IO: TX/RX commands only
    - Errors: only error responses
    Color-coded: purple=hw, orange=board, green=io, red=error
    [board.h, hardware.h, utils.h]
2026-03-17 Add verbose debug logging to hardware and board layers
    Hardware: SR state hex before/after, OE enable/disable, thermal
    cooldown remaining time, per-SR pin identification
    Board: grid-to-SR mapping trace, local coords in SR block,
    hex color on setRGB, full success/failure path logging
    [board.h, hardware.h]
2026-03-17 Add hardware watchdog thread for SR safety
    - FreeRTOS task on core 1 runs every 100ms
    - Writes sr_state_ to shift registers (keeps hw in sync)
    - Force-clears any bit that has been high longer than MAX_PULSE_MS
    - All sr_state_ access protected by mutex
    - bit_on_since_[] tracks when each bit was turned on
    - Watchdog is stopped cleanly on shutdown
2026-03-17 Port firmware to Rust (esp-hal, serde, embassy)
    firmware-rs/ — complete port of the C++ firmware:
    - api.rs: types with #[derive(Serialize)] — no manual toJson
    - hardware.rs: SPI shift registers, thermal tracking, watchdog
    - board.rs: coil grid mapping, pulse/state/RGB/shutdown
    - serial_server.rs: JSON command registry with serde_json
    - main.rs: entry point, peripheral init
    Stack: esp-hal 1.0 (bare metal), serde_json (alloc), embassy-time
    Compiles for xtensa-esp32s3-none-elf. Serial read TODO (needs
    USB JTAG serial peripheral wiring).
2026-03-17 Wire up USB Serial/JTAG for real serial I/O, add idle sleep
    - Split UsbSerialJtag into rx/tx for bidirectional comms
    - drain_rx_fifo for non-blocking byte reads
    - tx.write() for responses
    - 1ms sleep when no data (saves power vs busy-spin)
    - Timer-based watchdog tick instead of iteration counter
2026-03-18 Fix Rust firmware boot: add build.rs linker script, update deps
    The missing build.rs with `-Tlinkall.x` was the root cause of all
    boot failures. Without it, the binary had no ESP32 memory layout,
    no app descriptor section, and the linker stripped everything.
    Changes:
    - Add build.rs with linkall.x linker script (from esp-generate template)
    - Update deps to match official template: esp-backtrace removed
    (use inline panic handler), esp-alloc 0.9, esp-println 0.16
    - Add rust-toolchain.toml pinning to "esp" channel
    - Remove embassy deps (not needed for blocking serial)
    - All 3 API commands verified working on device
    [main.rs]
2026-03-18 Rename API types to clean domain names
    - PulseCoilRequest → PulseCoilParams
    - SetRGBRequest → RGBColor
    - PulseCoilResponse → PulseResult
    - GetBoardStateResponse → BoardState
    - SetRGBResponse/ShutdownResponse → CommandResult
    - Removed dead make_handler function
    - Regenerated TypeScript bindings with new names
    [board.rs, serial_server.rs]
2026-03-19 Remove all lifetime annotations, add ADC sensor reading
    - Hardware/Board/SerialServer are plain structs (no <'d>)
    - All esp-hal peripherals are 'static since main() -> ! never returns
    - 12 hall sensors wired via ADC1 (GPIO1-10) + ADC2 (GPIO11-12)
    - SensorPins struct stores typed AdcPins, match-based read_sensor()
    - No unsafe, no macros, no Box<dyn>
2026-03-19 Use Box<dyn> Vec for ADC pins, eliminate SensorPins struct and match
    - Two traits (Adc1Pin, Adc2Pin) type-erase the 12 different GPIO types
    - Pins stored in Vec<Box<dyn Adc1Pin>> and Vec<Box<dyn Adc2Pin>>
    - read_sensor is a simple index + 2-arm if/else, no match needed
    - No macros, no unsafe, no 12-field struct
2026-03-19 Move ADC traits to pins.rs, clean up hardware.rs
    Adc1Read/Adc2Read traits live in pins.rs alongside pin definitions.
    Hardware.rs is just the hardware driver, no trait definitions.
2026-03-19 Clean up pulse_bit: validate_pulse_bit returns PulseResult, board passes through
    - Hardware validates (bounds, thermal, duration) and returns PulseResult
    - Board maps grid coords, delegates to hw, logs result
    - No redundant validation between layers
    - CamelCase enum variants throughout
2026-03-19 Add reader watchdog: force-restart if no data for 5s
    WebSerial reader.read() can hang silently (Chrome USB CDC bug).
    A watchdog checks every 2s — if no data received for 5s and there's
    a pending request, it cancels the reader which triggers restart.
2026-03-19 Add board event system with monitor tick
    - BoardEvent enum with BoardChanged variant (serde tagged)
    - Board.tick() reads sensors and pushes event to queue
    - Board.drain_events() returns queued events
    - Main loop calls tick() at ~20Hz, drains events over serial
    - Events sent as {"type":"event","event":"board_changed","data":{...}}
    - ts-rs generates BoardEvent and BoardChangedEvent TypeScript types
2026-03-19 Add BoardConfig, fix calibrate for SensorGrid layout, fix typo
    - BoardConfig struct with current() to expose constants to frontend
    - Calibrate rewritten for SensorGrid<SensorCalibration> (4x3 grid)
    - SensorCalibration: baseline, coil_on, magnet_present (no delta)
    - Fixed id's typo in BoardState
    [board.rs]
2026-03-19 Add get_config command, fix SensorGrid throughout
    - get_config returns BoardConfig with grid/sensor dimensions + limits
    - read_all_sensors returns SensorGrid<u16> directly (no flat array)
    - get_board_state simplified (no manual grid mapping)
    - calibrate baseline loop uses grid indexing
    [board.rs, hardware.rs, serial_server.rs]
2026-03-19 Add NVS storage for calibration persistence
    - storage.rs: save/load CalibrationResult to ESP32 NVS flash
    - api_data! macro for types needing both Serialize + Deserialize
    - CalibrationResult + SensorCalibration now deserializable
    - esp-nvs + esp-storage dependencies added
    - Storage::new(flash) initializes NVS at partition offset 0x9000
2026-03-21 Update generated TypeScript bindings
    - BoardEvent simplified to notification-only (no payload)
    - CalibrationResult uses SensorGrid layout (4x3)
    - SensorCalibration: delta → magnet_present
2026-03-23 Get MVP compiling again: comment out WIP, stub unfinished features
    - Board: commented out move_piece, BoardState local struct, utils import
    - get_board_state returns BoardStateResponse with sensor data + zeroed ids/timestamps
    - calibrate returns empty stub (todo)
    - get_config commented out (BoardConfig removed during refactor)
    - All 4 commands working: board_state, pulse_coil, set_rgb, calibrate
2026-03-23 Sync frontend types with Rust backend API
    - api.ts: duration_ms → duration_us, raw_strengths → raw_sensor_values,
    PulseResult is now tagged union {status:"Success"|"Failure"}
    - CoilsWidget: updated pulse params and result handling
    - SurfaceWidget: GetBoardStateResponse → BoardStateResponse
    - Re-added commands registry for HTTP transport
2026-03-23 Update dev_serial.sh for Rust firmware
    Replaces arduino-cli with cargo+espflash, runs ts-rs codegen,
    then starts vite frontend.
2026-03-24 Add sensor_poll.py: pretty-print hall sensor grid at 10Hz
    Handles both raw_sensor_values (Rust) and raw_strengths (C++) field names.
2026-03-24 Disable USB-OTG pulls on GPIO 1/2 for correct ADC readings
    GPIO 1/2 are USB D+/D- with default pull-downs from USB-OTG peripheral.
    Setting pad_pull_override and clearing all pulls fixes ADC channels 0-1
    reading ~700 instead of true analog value (~2950).
    Other channels read 4095 (floating pins near VCC) — expected behavior
    on DevKit without hall sensors connected.
    [hardware.rs]
2026-03-24 Fix ADC readings: set data_inv + mask to 12 bits
    ESP32-S3 SAR ADC in RTC mode outputs inverted data by default.
    Setting sar_sar1_data_inv/sar_sar2_data_inv corrects this.
    Also mask to 12 bits since internal SAR is 13-bit.
    Readings now match C++ firmware: ~2030-2065 for 1.5V sensors.
    GPIO 1/2 still read high (~3300) due to USB-OTG trace routing.
    [hardware.rs]
2026-03-24 Switch back to C++ firmware, update SR pins, sync frontend
    - dev_serial.sh reverted to arduino-cli C++ build
    - pins.h: SR pins updated to GPIO 45/0/47/41
    - api.ts: regenerated + missing types added
    - Widgets synced with C++ field names
    [pins.h]
2026-03-24 Reduce SR SPI clock to 500kHz for long trace reliability
    4MHz was causing occasional missed shift register commands.
    500kHz gives plenty of margin for 12 daisy-chained 74HC595s
    with long PCB traces. 12 bytes at 500kHz = 192us per write.
    [hardware.h]
2026-03-24 Fix SR grid mapping: column-major (bottom→top, then right)
    SRs go SR0@(0,0) → SR1@(0,3) → SR2@(0,6) → SR3@(3,0) → ...
    sr_index = sr_col * SR_ROWS + sr_row (was sr_row * SR_COLS + sr_col)
    Updated both C++ and Rust firmware.
    [board.h, board.rs]
2026-03-25 Add piece tracking and dumb orthogonal move
    Board:
    - 10×7 pieces_ array (PIECE_NONE/WHITE/BLACK)
    - setPiece/getPiece for manual placement
    - moveDumbOrthogonal: moves along major axes (%3==0 coords),
    pulses each coil for 250ms sequentially from source to dest
    Serial commands:
    - set_piece: {x, y, id} — place a piece
    - get_pieces: returns array of {x, y, id} for non-empty squares
    - move_dumb: {from_x, from_y, to_x, to_y} — dumb orthogonal move
2026-03-25 Move pieces into getBoardState, remove get_pieces command
    - GetBoardStateResponse now includes pieces[10][7] grid
    - Removed redundant get_pieces command and handler
    - Frontend type updated: piece_count → pieces[][]
2026-03-25 Add MoveError enum, moveDumb with L-path planning, default board
    - MoveError: OUT_OF_BOUNDS, NOT_ON_MAJOR_GRID, NO_PIECE_AT_SOURCE,
    DESTINATION_OCCUPIED, NOT_ORTHOGONAL, COIL_FAILURE, SAME_POSITION
    - moveDumb(from, to): path-plans X-then-Y L-shaped moves,
    calls moveDumbOrthogonal for each leg
    - moveDumbOrthogonal: internal, steps by 3, pulses each coil
    MOVE_PULSE_REPEATS times with MOVE_DELAY_MS between
    - initDefaultBoard: 4 white at y=0, 4 black at y=6
    - move_dumb serial command returns {success, error}
    [api.h, board.h, serial_server.h]
2026-03-25 Simplify to moveDumbOrthogonal, add graveyard, wire up frontend
    - Removed moveDumb path planner and MoveError enum
    - moveDumbOrthogonal is the only move command (no validation)
    - killPiece sends a piece to the graveyard array
    - getBoardState returns pieces[][] + graveyard[]
    - Default board: 4 white at y=0, 4 black at y=6
    - Frontend api.ts: added moveDumb, killPiece, setPiece, piece constants
2026-03-25 Add move validation, 3 pieces per side, remove graveyard/kill
    - moveDumbOrthogonal validates: orthogonal, piece at source,
    path clear (no blocking pieces), coils exist along path
    - Returns MoveError enum (NONE, OUT_OF_BOUNDS, NOT_ORTHOGONAL,
    NO_PIECE_AT_SOURCE, PATH_BLOCKED, COIL_FAILURE, SAME_POSITION)
    - Default board: 3 white at (0,0)(3,0)(6,0), 3 black at (0,6)(3,6)(6,6)
    - Removed graveyard storage and kill_piece (graveyard is just the
    right-side board squares managed by the frontend)
    - Step size auto-detects: major grid moves step by 3, others by 1
2026-03-26 Add falloff_exp parameter to physics move spec
    Tunable exponent for coil force distance falloff to better model
    the actual force profile of z-aligned coil/magnet interaction.
2026-03-26 Add sensor distance model and velocity correction to physics spec
    Sensor uses same force model shape inverted to estimate distance from
    reading strength. Velocity correction blends sensor-derived velocity
    into simulation at a hardcoded weight constant.
2026-03-26 Add physics move implementation plan
    8-task plan covering: sustainCoil in Hardware, physics.h with simulation
    loop, removal of old smart move code, Board integration, API/serial
    handler, frontend physics toggle with param tuning.
2026-03-26 feat: add physics.h with simulation loop, PieceState, PhysicsParams
    Implements physics-based piece movement simulation for the ESP32 electromagnetic
    chess board, including force model, friction, sensor correction, coil switching,
    arrival detection, and braking logic.
    [physics.h]
2026-03-26 feat: wire PhysicsMove into Board with movePhysicsOrthogonal
2026-03-26 Physics-based piece movement with simulation loop, sensor correction, directional velocity control, host-side tests, and tuning infrastructure
    - physics.h: PieceState, PhysicsParams, PhysicsMove with sub-ms simulation
    - Force model: F = k * d / (d^exp + epsilon) — zero at center, peaks at intermediate d
    - Controller computes duty from desired force vs available force
    - Sensor correction: only when closer to center, directional awareness
    - Friction: static/kinetic with clamping to prevent velocity reversal
    - hardware.h: startCoil/stopCoil/sustainCoil for non-blocking control, 10kHz PWM
    - Removed watchdog coil-time enforcement (thermal model handles it)
    - board.h: movePhysicsOrthogonal, tune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
    [pawn.dxf]
2026-03-26 Add physics auto-tuning system design spec
    4-phase tuning: sensor curve fit, static friction, coil force profile,
    move verification. Returns recommended PhysicsParams for one-click apply.
2026-03-26 Add physics auto-tuning implementation plan
    4 tasks: tunePhysics method with 4 phases, API update, frontend
    Apply Recommended flow, flash and verify.
2026-03-26 feat: replace tunePhysics with 4-phase auto-tuning system
    [board.h]
2026-03-26 feat: add Tune Physics button with Apply Recommended flow
2026-03-26 Add force table generator design spec
    Python script using Biot-Savart to precompute 5-layer lateral force
    lookup tables (39x39 full grid at 1mm resolution) for ESP32 physics sim.
2026-03-26 Add force table generator implementation plan
    2 tasks: Python script generating 5-layer force tables from Biot-Savart,
    then verify header compiles on ESP32.
2026-03-26 feat: add precomputed 5-layer force tables for ESP32 physics engine
2026-03-26 Regenerate force tables for 12mm dia, 3mm height magnet (N42)
2026-03-26 Add stopping strategy (passive coast + active brake) to physics spec
2026-03-26 Add real-units physics implementation plan
    4 tasks: physics.h rewrite (force tables, dynamic friction, stopping),
    board.h mm paths, API/frontend update, host tests.
2026-03-26 feat: board path building in mm, PieceState positions in mm
2026-03-26 feat: update host tests for real-unit physics
    Fix simulation loop to use actual applied current for normal force /
    friction calculation (not always max_current_a), and solve for current
    analytically accounting for Fz-dependent friction. All 21 tests pass.
    [test_physics.cpp]
2026-03-27 Good movement at this stage
    Tuned physics params that produce smooth, reliable piece movement:
    piece_mass_g: 4.3
    max_current_a: 1.2
    mu_static: 0.55
    mu_kinetic: 0.45
    target_velocity: 300 mm/s
    target_accel: 1500 mm/s²
    max_jerk: 20000 mm/s³
    active_brake: true
    all_coils_equal: false
    pwm_freq_hz: 20000
    pwm_compensation: 0.2
    force_scale: 1.0
    max_duration_ms: 5000
2026-03-27 Add sensor diagnostics + checkpoint recovery design spec
2026-03-27 Update spec: recovery only triggers on destination checkpoint failure
    The physics move always runs to full completion before recovery.
    Missed intermediate sensors are diagnostic data, not failures.
    Recovery scans backwards from destination to find last detected coil.
2026-03-27 Add sensor diagnostics + checkpoint recovery implementation plan
2026-03-27 feat: add MoveDiag and CoilDiag structs for sensor diagnostics
2026-03-27 feat: add sensor sampling to physics tick dead time
2026-03-27 feat: wire sensor diagnostics and checkpoint recovery into movePhysicsOrthogonal
2026-03-27 feat: thread max_retry_attempts through movePiece and hexapawnPlay
2026-03-28 feat: update for 9mm/1.5mm magnet, replace TuneWidget with Physics Settings
    - Update piece mass default to 2.7g (new lighter piece)
    - Update magnet dimensions in force table generator (9mm dia, 1.5mm height)
    - Replace TuneWidget with PhysicsSettingsWidget (edit/save params, reset defaults)
    - Strip param editor from MoveTestWidget (now just 3 test buttons + logs)
    - All widgets visible by default in App.tsx
    - Fix hardcoded mass assertions in verify_physics tests
    NOTE: Force tables need regeneration with: cd simulations && python generate_force_table.py
    [physics.h, test_physics.cpp, verify_physics.cpp]
2026-03-28 fix: add max_retry_attempts to PhysicsParams, fix sensor diagnostic per-coil bug
    - max_retry_attempts stored in PhysicsParams (default 0), persisted to NVS
    - All move functions default to -1 (inherit from params) instead of hardcoded 0
    - Hexapawn AI no longer hardcodes retries=2, uses params like everything else
    - Sensor diagnostics now only track sensors at major grid positions (every 3 units)
    where Hall sensors physically exist, instead of reporting per-coil (which was
    reading the same sensor 3x and showing misleading duplicate entries)
    - Physics Settings widget includes max_retry_attempts
    [board.h, physics.h, serial_server.h]
2026-03-28 fix: correct Fz sign (increases friction, not decreases), remove active decel
    - Fz is negative in force tables (pulls magnet toward PCB). This INCREASES
    normal force and friction, not decreases it. Fixed: normal = weight - fz*I
    - Controller never actively decelerates — clamped desired_accel >= 0
    - MoveTestWidget: clear all pieces and reset each test run
    - test_coil_trap uses real force tables, reproduces stuck behavior
    [physics.h, test_coil_trap.cpp]
2026-03-28 feat: net-acceleration coil switching — eliminates coil center trapping
    The old coil switching required the piece to pass 0.1mm past a coil center.
    But the coil pulls the magnet down (Fz), increasing normal force and friction
    to ~103mN — far exceeding the ~47mN max lateral force. The piece was trapped.
    New approach: each tick, compare the net forward acceleration (lateral force
    minus Fz-enhanced friction) of the current coil vs the next coil. Switch
    when the next coil would produce better acceleration. This naturally switches
    at roughly the midpoint between coils, well before the friction trap.
    Test results with real force tables: 100% success across all velocity (25-300)
    and current (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
2026-03-28 fix: log every physics tick, only clear board on collision error
    - Physics debug log fires every tick instead of fragile 10ms boundary check
    - MoveTestWidget only clears board if move fails with PATH_BLOCKED (error 5)
    [physics.h]
2026-03-29 fix: PWM compensation only applies when duty >= 1 (duty=0 means coil off)
    [physics.h]
2026-03-29 test: sync test_coil_trap with firmware (1ms tick, PWM comp fix, no-decel)
    All velocity and current combinations pass with real force tables.
    [test_coil_trap.cpp]
2026-03-29 fix: prevent PWM comp dead zone — ensure duty >= 1 when force is requested
    PWM compensation maps desired current to raw duty via inverse formula.
    With comp > 0, small current requests map to raw_duty < 0, clamped to 0,
    giving zero current. The jerk limiter ramps slowly, so early ticks all
    hit this dead zone — piece unsticks but never moves.
    Fix: when desired_force > 0, clamp duty to at least 1.
    Added PWM comp sweep test — all values 0-0.5 pass.
    [physics.h, test_coil_trap.cpp]
2026-03-29 feat: remove jerk limiting, 12-bit PWM duty, allow negative desired_accel
    - Remove jerk limiter — was causing slow acceleration ramp at 1ms ticks
    (max_da = 50000 * 0.001 = 50 mm/s² per tick, taking 10ms to reach 500)
    - Switch from 8-bit (0-255) to 12-bit (0-4095) PWM duty for 16x finer
    current resolution — eliminates coarse quantization with high max_current
    - Allow negative desired_accel (reducing force) but clamp desired_force >= 0
    (never actively brake, let friction handle deceleration)
    - analogWriteResolution set to 12 in hardware init
    - All pulseBit/startCoil/sustainCoil use uint16_t duty, max 4095
    - Test passes all velocity, current, and PWM comp sweeps
2026-03-29 revert: undo 12-bit PWM (ESP32-S3 doesn't support it), keep no-jerk + neg accel
    - Reverted all 12-bit PWM changes back to 8-bit (0-255)
    - Kept: jerk limiting removed, negative desired_accel allowed
    - Added: warning log when negative acceleration is requested
    - All tests pass with 8-bit duty
    [board.h, hardware.h, physics.h, test_coil_trap.cpp]
2026-03-29 fix: log every physics tick, only clear board on collision error
    [physics.h]
2026-03-29 fix: add acceleration to physics debug log
    [physics.h]
2026-03-29 fix: duty=1 floor only when accelerating, remove per-tick warning spam
    duty=1 minimum was keeping the coil on even when the controller wanted
    zero force (above target velocity). With PWM comp, duty=1 gives ~20% current
    which kept accelerating the piece to 150% of target and beyond.
    Fix: duty=1 floor only when desired_accel > 0. When the controller wants to
    reduce force (negative desired_accel), duty=0 is allowed — coil turns off
    and friction decelerates the piece naturally.
    [physics.h, test_coil_trap.cpp]
2026-03-29 fix: use coast_friction_offset in actual coast friction, not just prediction
    The stopping distance prediction used mu_kinetic + coast_friction_offset,
    but the actual friction during coast used plain mu_kinetic. This mismatch
    meant the sim predicted a shorter coast than it actually simulated, causing
    the piece to stop short of the destination in the sim.
    Also: fire centering pulse when piece stops during coast regardless of
    distance to destination — handles sim/reality mismatch where the real
    piece coasts further than the sim predicts.
    [physics.h]
2026-03-29 fix: clamp net acceleration to 3x target_accel to prevent friction spikes
    Near coil centers, Fz inflates normal force to ~228mN (vs 26.5mN weight),
    causing friction spikes of 90+ mN that produce decelerations of 15000+ mm/s².
    Clamp total acceleration magnitude to 3x target_accel for stability.
    [physics.h]
2026-03-29 fix: only clamp acceleration during powered movement, not during coast
    The accel clamp was limiting friction deceleration during coast to 2250 mm/s²
    when actual gravity-only friction produces 4417 mm/s². This caused the sim to
    undershoot its stopping prediction and overshoot the destination.
    [physics.h]
2026-03-29 fix: update default sensor thresholds for 9mm magnet (threshold=1950)
    Baseline default 2040, piece_mean default 1860, midpoint threshold 1950.
    The smaller 9mm magnet produces weaker Hall readings than the old 12mm.
    [board.h]
2026-03-29 fix: killPiece uses dumb moves, prefer clear Manhattan paths
    killPiece was calling movePiece which recursively cleared obstructions,
    displacing other pieces on the board during captures. Now uses
    moveDumbOrthogonal with skipValidation to move captured pieces to the
    graveyard without disturbing the board.
    Also: movePiece Manhattan routing explicitly prefers 0-obstruction paths
    before falling back to fewer-obstruction paths.
    [board.h]
2026-03-29 fix: killPiece picks graveyard slot with fewest obstructions
    Previously used the first empty slot, which could route through other
    pieces and trigger recursive displacement. Now evaluates all empty
    graveyard slots and picks the one whose Manhattan path has the fewest
    obstructions, preferring zero-obstruction routes.
    [board.h]
2026-03-30 feat: diagonal move test — multi-coil catapult + catch + center
    Hardware: startCoils() activates multiple SR bits simultaneously,
    stopAllCoils() clears all.
    Board: diagonalTest() fires symmetric coil pairs in sequence:
    1. Catapult: origin pair (1,0)+(0,1) at full duty for catapult_ms
    2. Mid-push: (2,0)+(0,2) pair to extend range
    3. Catch: all destination coils (3,1)+(1,3), (3,2)+(2,3), (3,3)
    4. Center: final pulse on destination coil
    Frontend: DiagonalTestWidget with configurable timing parameters
    and 4 test buttons for different diagonal directions.
2026-03-30 refactor: diagonal test into 3 distinct phases with delays
    Phase 1: CATAPULT — (1,0)+(0,1)+(2,0)+(0,2) at full duty, then off
    Coast delay: configurable gap for piece to travel through dead zone
    Phase 2: CATCH — (3,2)+(2,3) to pull piece into destination block
    Settle delay: let piece decelerate before centering
    Phase 3: CENTER — pulse (3,3) to snap to destination
    [board.h, serial_server.h]
2026-03-30 feat: edge move test widget — move piece between coil columns
    Moves piece along x=1.5 (between columns 0 and 3) by activating
    symmetric coil pairs: (0,y)+(3,y) for each step.
    Sequence: step through y=0→3 (up) or y=3→0 (down), activating
    both flanking coils simultaneously for configurable duration/duty,
    with delays between steps. Final centering pulse on last position.
2026-04-02 feat: multi-move physics engine — simultaneous piece movement
    New discrete on/off coil control: no PWM during moves. OE stays enabled,
    SR bits control individual coils. Each tick decides per-move: coil ON
    (below target velocity) or OFF (above target, let friction decelerate).
    API: queueMove() + executeMulti() runs up to 4 moves simultaneously.
    Each move has independent coil switching, coast detection, centering.
    All active coil bits combined into one SR write per tick.
    Added tick_ms parameter (default 10ms) to PhysicsParams, persisted to
    NVS, editable from Physics Settings widget. Controls physics tick rate
    and coil switching frequency.
2026-04-02 feat: move_multi API — simultaneous orthogonal piece movement
    Board::moveMulti() validates, builds paths, queues, and executes
    multiple orthogonal moves simultaneously using executeMulti().
    Serial API: move_multi with indexed params (0_from_x, 0_from_y, etc.)
    Frontend: moveMulti() flattens move array into indexed params.
    Also: tick_ms added to PhysicsSettings widget and NVS persistence.
2026-04-03 feat: diagonal moves in physics engine + moveMulti supports mixed moves
    MoveSlot now supports both orthogonal (single coil path) and diagonal
    (coil group path). Diagonal moves use 3 coil groups:
    1. Catapult: (1,0)+(0,1)+(2,0)+(0,2) — symmetric origin pairs
    2. Catch: (3,1)+(1,3)+(3,2)+(2,3)+(3,3) — destination block coils
    3. Center: (3,3) — final centering
    Group switching uses net forward acceleration comparison, same as
    orthogonal coil switching. SR bit collection handles multiple bits
    per group across multiple simultaneous moves.
    moveMulti API now accepts both orthogonal and diagonal moves in the
    same batch.
2026-04-07 fix: add missing types to api.h so codegen produces correct TypeScript
    Added to SetPhysicsParamsRequest: max_retry_attempts, tick_ms
    Added structs: DiagonalTestRequest, DiagonalTestResponse, MoveMultiRequest
    Added API_COMMAND entries: diagonal_test, move_multi, edge_move_test
    Created api-extensions.ts for commands with custom client-side logic
    (moveMulti indexed params, edgeMoveTest direction string).
    [api.h]
